zyu43796-byte/Microfluidic-device/hardware/Drop_Board/板2PCB_V1/BD2_yd_V1.0_加工要求.docx

1. 板厚1.6mm，4层板，机械1层做外形和打孔。
2. 绿色，FR-4，过孔塞油。
