zyu43796-byte/Microfluidic-device/hardware/Drop_Board/板4PCB_V1/BD4_yd_V1.0.PcbDoc.htm

Reporting Options

# File in Previous Format

Date | : | 2026-03-22
Time | : | 21:35:51
Filename | : | C:\Users\starry\Desktop\Scientific research horizontal and vertical\玻璃基微型液滴驱动线路板项目\最终版本\液滴电路板WORK\板4PCB_V1\BD4_yd_V1.0.PcbDoc

Version | Warning
Release 12 | CAUTION - Air Gap Width previously controlled by Clearance rule is now controlled by Polygon Connect Style rule's newly introduced Air Gap Width (set to default value). Suggest reviewing each Polygon Connect Style rule's Air Gap Width attribute for correctness.
Release 13 | CAUTION - Silkscreen Over Component Pads Rules are converted to Silk To Solder Mask Clearance Rules. Suggest examining rule scopes for accuracy.

This file was generated by an earlier version of the software
