zyu43796-byte/Microfluidic-device/hardware/Drop_Board/板1PCB_V1/BD1_yd_V1.0_加工要求.docx

1. 板厚2mm，4层板，机械1层做外形和打孔。
2. 绿色，FR-4，过孔塞油。
