zyu43796-byte/Microfluidic-device/hardware/Drop_Board/板4PCB_V1/Project Outputs for Main_board4/Net Status - BD4_dy_V1.html

Altium customize

# Net Status Report

Date | : | 2026/3/2
Time | : | 23:29:19
Elapsed Time | : | 00:00:00
Filename | : | E:\刘博士二版项目\液滴电路板WORK\液滴电路板WORK\板4PCB_V1\BD4_dy_V1.0.PcbDoc
Units | : | mmmils

Nets | Layer | Length
5V | Signal Layers Only | 2730.47mils
DVDD12 | Signal Layers Only | 500.083mils
GND | Signal Layers Only | 7104.11mils
HUB_CC/GPIO1 | Signal Layers Only | 0mils
NetC14_1 | Signal Layers Only | 321.703mils
NetC1_1 | Signal Layers Only | 0mils
NetC1_2 | Signal Layers Only | 124.183mils
NetC22_2 | Signal Layers Only | 623.926mils
NetC40_2 | Signal Layers Only | 398.917mils
NetC41_1 | Signal Layers Only | 304.851mils
NetC42_1 | Signal Layers Only | 283.302mils
NetC44_1 | Signal Layers Only | 332.945mils
NetC46_1 | Signal Layers Only | 3611.28mils
NetC5_2 | Signal Layers Only | 264.728mils
NetC65_1 | Signal Layers Only | 0mils
NetC65_2 | Signal Layers Only | 134.455mils
NetC69_2 | Signal Layers Only | 312.767mils
NetC76_1 | Signal Layers Only | 1425.101mils
NetC85_2 | Signal Layers Only | 126.951mils
NetC94_1 | Signal Layers Only | 280.891mils
NetD10_2 | Signal Layers Only | 0mils
NetD11_2 | Signal Layers Only | 0mils
NetD1_1 | Signal Layers Only | 0mils
NetD8_1 | Signal Layers Only | 3896.258mils
NetH1_1 | Signal Layers Only | 657.583mils
NetH1_2 | Signal Layers Only | 428.135mils
NetH2_2 | Signal Layers Only | 497.015mils
NetH2_3 | Signal Layers Only | 652.686mils
NetH3_3 | Signal Layers Only | 715.537mils
NetK1_8 | Signal Layers Only | 541.645mils
NetLED1_1 | Signal Layers Only | 74.657mils
NetLED2_1 | Signal Layers Only | 71.9mils
NetLED5_1 | Signal Layers Only | 108.025mils
NetP10_1 | Signal Layers Only | 2580.602mils
NetP10_2 | Signal Layers Only | 2557.548mils
NetP10_3 | Signal Layers Only | 794.202mils
NetP10_4 | Signal Layers Only | 2676.501mils
NetP10_5 | Signal Layers Only | 2612.375mils
NetP10_6 | Signal Layers Only | 6292.215mils
NetP10_7 | Signal Layers Only | 2617.896mils
NetP10_8 | Signal Layers Only | 6358.13mils
NetP1_1 | Signal Layers Only | 178mils
NetP3_2 | Signal Layers Only | 0mils
NetQ1_1 | Signal Layers Only | 91.957mils
NetQ2_1 | Signal Layers Only | 0mils
NetQ2_3 | Signal Layers Only | 0mils
NetR16_1 | Signal Layers Only | 444.55mils
NetR17_1 | Signal Layers Only | 427.82mils
NetR2_2 | Signal Layers Only | 261.185mils
NetR43_2 | Signal Layers Only | 310.285mils
NetR45_2 | Signal Layers Only | 987.021mils
NetR48_1 | Signal Layers Only | 110.764mils
NetR6_1 | Signal Layers Only | 82.445mils
NetR8_1 | Signal Layers Only | 77.477mils
OLED_CS | Signal Layers Only | 0mils
OLED_DC | Signal Layers Only | 0mils
OLED_RES | Signal Layers Only | 0mils
OVCUR# | Signal Layers Only | 1632.176mils
P1C_N | Signal Layers Only | 458.976mils
P1C_P | Signal Layers Only | 473.818mils
P1_AS_DX_N | Signal Layers Only | 1367.024mils
P1_AS_DX_P | Signal Layers Only | 1455.835mils
P1_SS_RX_N | Signal Layers Only | 880.331mils
P1_SS_RX_P | Signal Layers Only | 896.364mils
P1_SS_TX_N | Signal Layers Only | 416.21mils
P1_SS_TX_P | Signal Layers Only | 414.817mils
P2C_N | Signal Layers Only | 418.633mils
P2C_P | Signal Layers Only | 413.717mils
P2_AS_DX_N | Signal Layers Only | 2218.174mils
P2_AS_DX_P | Signal Layers Only | 2269.872mils
P2_SS_RX_N | Signal Layers Only | 1425.024mils
P2_SS_RX_P | Signal Layers Only | 1445.144mils
P2_SS_TX_N | Signal Layers Only | 1274.258mils
P2_SS_TX_P | Signal Layers Only | 1293.818mils
P3C_N | Signal Layers Only | 406.763mils
P3C_P | Signal Layers Only | 402.433mils
P3_AS_DX_N | Signal Layers Only | 2649.381mils
P3_AS_DX_P | Signal Layers Only | 2733.871mils
P3_SS_RX_N | Signal Layers Only | 2528.884mils
P3_SS_RX_P | Signal Layers Only | 2473.547mils
P3_SS_TX_N | Signal Layers Only | 2537.716mils
P3_SS_TX_P | Signal Layers Only | 2570.689mils
P4_AS_DX_N | Signal Layers Only | 1068.423mils
P4_AS_DX_P | Signal Layers Only | 1045.576mils
P4_SS_RXA | Signal Layers Only | 0mils
P4_SS_RXB | Signal Layers Only | 0mils
P4_SS_TXA | Signal Layers Only | 0mils
P4_SS_TXB | Signal Layers Only | 0mils
PWREN# | Signal Layers Only | 1681.622mils
PWR_CC/GPIO0/BC_EN# | Signal Layers Only | 590.477mils
RESET# | Signal Layers Only | 211.484mils
SMBCLK/SCL/EXCH# | Signal Layers Only | 886.937mils
SMBDAT/SDA | Signal Layers Only | 927.03mils
SPI_MISO_2 | Signal Layers Only | 0mils
SPI_MOSI_2 | Signal Layers Only | 2162.403mils
SPI_SCK_2 | Signal Layers Only | 0mils
SUSP/PDHUB# | Signal Layers Only | 526.075mils
SWITCH_IN01 | Signal Layers Only | 0mils
SWITCH_IN02 | Signal Layers Only | 0mils
UPC_N | Signal Layers Only | 424.19mils
UPC_P | Signal Layers Only | 419.237mils
UP_AS_DX_N | Signal Layers Only | 1791.996mils
UP_AS_DX_P | Signal Layers Only | 1810.854mils
UP_SS_RX_N | Signal Layers Only | 1753.375mils
UP_SS_RX_P | Signal Layers Only | 1754.34mils
UP_SS_TX_N | Signal Layers Only | 1334.11mils
UP_SS_TX_P | Signal Layers Only | 1354.856mils
USB_5V | Signal Layers Only | 1915.437mils
VBUS_OUT1 | Signal Layers Only | 378.64mils
VBUS_OUT2 | Signal Layers Only | 1978.583mils
VCC_3.3V | Signal Layers Only | 7080.935mils
VCC_5V | Signal Layers Only | 2696.448mils
VDD33 | Signal Layers Only | 7088.882mils
VIN1_12V | Signal Layers Only | 160.886mils
VIN2_12V | Signal Layers Only | 453.186mils
VIN4_12V | Signal Layers Only | 0mils
VIN5_12V | Signal Layers Only | 0mils
VSW | Signal Layers Only | 46.927mils
XI | Signal Layers Only | 376.175mils
XO | Signal Layers Only | 341.821mils

Back to top
