zyu43796-byte/Microfluidic-device/firmware/DRIVE/通信协议.rtf

数字微流控课题组通信协议定义
上位机底板 | 底板加热 | 加热底板 | 底板上位机
| 帧头（2 Byte） | 模块地址（1 Byte） | 命令（1 Byte） | 数据长度（1 Byte） | 数据（x Byte） | 帧尾（2Byte） | 说明 | | | | 说明
底板 | A5A5 | 00 | 01 | 00 | | 5A5A | 芯片压实检测命令 | | | XX | 00压实 01未压实
| A5A5 | 00 | 02 | 00 | | 5A5A | 阵列电压反馈 | | | XX XX | ADC采样 高字节前 低字节后
| A5A5 | 00 | 03 | 00 | | 5A5A | 脉冲电压反馈 | | | XX XX
| A5A5 | 00 | 04 | 02 | Xx xx | 5A5A | 读取EEPROM数据,读取一个;高地址前低地址后 | | | XX
| A5A5 | 00 | 05 | 03 | Xx xx xx | 5A5A | 写入EEPROM数据,写入一个;高地址前低地址后
驱动 | A5A5 | 01 | 05 | 01 | Xx | 5A5A | 设定测试延迟时间1
| A5A5 | 01 | 06 | 01 | Xx | 5A5A | 设定测试延迟时间2
| A5A5 | 01 | 07 | 02 | Xx XX | 5A5A | 设定驱动电压值40-270
| A5A5 | 01 | 08 | 10 | Xx …… xx | 5A5A | 设定控制逻辑
| A5A5 | 01 | 01 | 00 | | 5A5A | 读取电压设定值 | | | XX | 返回已设定值
| A5A5 | 01 | 02 | 00 | | 5A5A | 读取周期设定值 | | | XX
| A5A5 | 01 | 03 | 00 | | 5A5A | 读取控制逻辑 | | | XXXX
| A5A5 | 01 | 04 | 01 | XX | 5A5A | 设定直流交流模式DC:02,AC:03,关闭:01
加热 | A5A5 | 02 | 00 | 00 | | 5A5A | 确认加热模块是否连接正常 | A5 A5 02 00 00 5A5A | A5 A5 02 00 04 XX XX XX XX 5A5A | XX XX XX XX | 返回左右两侧温度
| A5A5 | 02 | 01 | 01 | 01/00 | 5A5A | 左侧启动/左侧停止 | A5 A5 02 01 01 XX 5A 5A | A5 A5 02 01 01 XX 5A 5A | XX | 返回左侧设定状态
| A5A5 | 02 | 02 | 01 | 01/00 | 5A5A | 右侧启动/右侧停止 | A5 A5 02 02 01 XX 5A 5A | A5 A5 02 02 01 XX 5A 5A | XX | 返回右侧设定状态
| A5A5 | 02 | 03 | 02 | Xx xx | 5A5A | 设定左侧目标温度 高字节前低字节后 | A5 A5 02 03 02 XX XX 5A 5A | A5 A5 02 03 02 XX XX 5A 5A | XX XX | 返回左侧设定温度
| A5A5 | 02 | 04 | 02 | Xx xx | 5A5A | 设定右侧目标温度 高字节前低字节后 | A5 A5 02 04 02 XX XX 5A 5A | A5 A5 02 04 02 XX XX 5A 5A | XX XX | 返回右侧设定温度
| A5A5 | 02 | 05 | 06 | Xx xx xx xx xx xx | 5A5A | 设置左侧PID参数 P/I/D高字节前低字节后 | A5 A5 02 05 06 XX XX XX XX XX XX 5A 5A | A5 A5 02 05 06 XX XX XX XX XX XX 5A 5A | XX XX XX XX XX XX | 返回左侧PID参数
| A5A5 | 02 | 06 | 06 | Xx xx xx xx xx xx | 5A5A | 设置右侧PID参数 P/I/D高字节前低字节后 | A5 A5 02 06 06 XX XX XX XX XX XX 5A 5A | A5 A5 02 06 06 XX XX XX XX XX XX 5A 5A | XX XX XX XX XX XX | 返回右侧PID参数
| A5A5 | 02 | 07 | 00 | | 5A5A | 获取当前左侧温度 | A5 A5 02 07 00 5A 5A | A5 A5 02 07 02 XX XX 5A 5A | XX XX | 高字节前低字节后
| A5A5 | 02 | 08 | 00 | | 5A5A | 获取当前右侧温度 | A5 A5 02 08 00 5A 5A | A5 A5 02 08 02 XX XX 5A 5A | XX XX | 高字节前低字节后
| A5A5 | 02 | 09 | 00 | | 5A5A | 获取当前左侧PID参数 | A5 A5 02 09 00 5A 5A | A5 A5 02 09 06 XX XX XX XX XX XX 5A 5A | XX XX XX XX XX XX | P/I/D高字节前低字节后
| A5A5 | 02 | 0a | 00 | | 5A5A | 获取当前右侧PID参数 | A5 A5 02 0A 00 5A5A | A5 A5 02 0A 06 XX XX XX XX XX XX 5A 5A | XX XX XX XX XX XX | P/I/D高字节前低字节后
| A5A5 | 02 | 0b | 00 | | 5A5A | 获取当前左侧加热功率 | A5 A5 02 0b 00 5A 5A | A5 A5 02 0b 02 XX XX 5A 5A | XX XX | 返回左侧加热功率
| A5A5 | 02 | 0c | 00 | | 5A5A | 获取当前右侧加热功率 | A5 A5 02 0c 00 5A 5A | A5 A5 02 0c 02 XX XX 5A 5A | XX XX | 返回右侧加热功率
OLED显示 | A5A5 | 03 | 01 | 00 | | 5A5A | 清屏
| A5A5 | 03 | 02 | 00 | | 5A5A
| A5A5 | 03 | 03 | 00 | | 5A5A | 显示参数
| A5A5 | 03 | 04 | 00 | | 5A5A | 显示状态
磁铁 | A5A5 | | | | | 5A5A
| A5A5 | | | | | 5A5A
荧光 | A5A5 | | | | | 5A5A
| A5A5 | | | | | 5A5A

A5 a5 01 08 10 00 00 00 01 00 00 00 00 00 00 00 00 00 00 00 00 5a 5a
