zyu43796-byte/Microfluidic-device/hardware/Drop_Board/板2PCB_V1/BD2_yd_V1.0_BOM.xlsx

序号 | 名称 | 规格型号 | 标号 | 封装 | 数量 | 立创商城编号 | 厂家型号 | 品牌 |  |  | LibRef
1 | 直插固态电容 | 220UF/50V | C1, C2, C9 | CAP 5.0*10*12.5 | 3 | C19270689 | JBLH2221M050E125RLM 2 | DMBJ(振宝佳) |  | C-CAP
2 | 直插固态电容 | 470uF /16V | C3, C6 | CAP-TH_BD8.0-P3.50-D0.6-FD | 2 | C19270650 | JBLE2471M016D090RLM 4 | DMBJ(振宝佳) |  | JBLE2471M016D090RLM 470UF 16V
3 | 无极性贴片电容 | 100nF | C4, C10, C11, C12, C21, C22, C23, C24, C25, C26, C27, C33, C38, C41, C42, C43, C44, C45, C50, C51, C52, C55, C59, C60, C61, C65, C66, C68 | C0603 | 28 | C14663 | CC0603KRX7R9BB104 | YAGEO(国巨) |  | CGA0603X7R104K500JT
4 | 无极性贴片电容 | 10uF/50V | C5, C37, C56, C62, C67 | C1206 | 5 | C13585 | CL31A106KBHNNNE | SAMSUNG(三星) (https://list.szlcsc.com/brand/254.html) |  | CL31B106KBHNNNE
5 | 直插电解电容 | 220uF/100V | C7 | CAP-TH_BD10.0-P5.00-D0.6-FD-A | 1 | C106683 | ERS1KM221K20OT | AISHI(艾华集团) (https://list.szlcsc.com/brand/1052.html) |  | 2210631013R00
6 | 无极性贴片电容 | 100nF/100V | C8, C40, C47, C63 | C0805 | 4 | C28233 | CL21B104KCFNNNE (https://item.szlcsc.com/28983.html?fromZone=s_s__%220.1uf%20100V%200805%22&c=Z) | SAMSUNG(三星) (https://list.szlcsc.com/brand/254.html?c=Z) |  | CL21B104KCFNNNE
7 | 无极性贴片电容 | 22uF | C13, C53, C54, C58 | C0805 | 4 | C45783 | CL21A226MAQNNNE (https://item.szlcsc.com/46786.html?fromZone=s_s__%2222uF%200805%22&c=Z) | SAMSUNG(三星) (https://list.szlcsc.com/brand/254.html?c=Z) |  | FCC0805X226M250FT
8 | 无极性贴片电容 | 20pF | C19, C20 | C0603 | 2 | C1648 | CL10C200JB8NNNC | SAMSUNG(三星) (https://list.szlcsc.com/brand/254.html?c=Z) |  | CL10C200JB8NNNC
9 | 无极性贴片电容 | 10uF/100V | C39, C46, C64 | C2220 | 3 | C2843466 | FS55X106K101EGG | PSA(信昌电陶) |  | FS55X106K101EGG
10 | 4P连接器 | WAFER-XH254Z-4A | CN2, CN4 | CONN-TH_XH-4A | 2 | C22751788 | WAFER-XH254Z-4AH | HANBO(汉博) (https://list.szlcsc.com/brand/12025.html?c=Z) |  | WAFER-XH254Z-4A
11 | TVS | SMBJ15CA | D2 | SMB_L4.6-W3.6-LS5.4-BI | 1 | C78809 | SMBJ15CA (https://item.szlcsc.com/79946.html?fromZone=s_s__%22SMBJ15CA%22&c=Z) | Littelfuse(美国力特) (https://list.szlcsc.com/brand/110.html?c=Z) |  | SMBJ15CA_C19077570
12 | 肖特基二极管 | SS310 | D3 | SMA_L4.3-W2.6-LS5.0-FD | 1 | C18199183 | SS310B | R+O(宏嘉诚) |  | SS310_C7420364
13 | TVS | SMBJ51CA | D4 | SMB_L4.4-W3.6-LS5.3-BI | 1 | C151265 | SMBJ51CA | Littelfuse(美国力特) |  | SMBJ51CA_C41376101
14 | TVS | SMAJ5.0CA | D5 | SMA_L4.4-W2.6-LS5.0-BI | 1 | C83324 | SMAJ5.0CA | Littelfuse(美国力特) |  | SMAJ5.0CA_C83324
15 | TVS | SMAJ3.3CA | D6 | SMA_L4.4-W2.6-LS5.0-BI | 1 | C2959732 | SMAJ3.3CA | DOWO(东沃) |  | SMAJ3.3CA_C2959732
16 | 肖特基二极管 | MBRS330T3 | D7 | MBRS340 | 1 | C5563747 | MBRS330T3G | FUXINSEMI(富芯森美) |  | DIODE SCHOTTKY
17 | 电感 | 10uH | L1 | IND-SMD_L5.4-W5.2_FXL0530 | 1 | C177248 | FXL0530-100-M | cjiang(长江微电) (https://list.szlcsc.com/brand/11425.html?c=Z) |  | FXL0530-100-M
18 | 电感 | 15uH | L2 | IND-SMD_L7.0-W6.6_FXL0630 | 1 | C177243 | FXL0630-150-M | cjiang(长江微电) |  | FXL0630-150-M
19 | 磁珠 | BLM18PG121SN1D | L3 | L 0603 | 1 | C14709 | BLM18PG121SN1D | muRata(村田) |  | BLM18PG121SN1D
20 | LED灯 | NCD0603G1 | LED1, LED2, LED_h1, LED_h2, LED_h3 | LED0603-RD_1 | 5 | C84267 | NCD0603G1 | 国星光电 |  | NCD0603G1
21 | 2P连接器 | Header 2H | P1 | CONN-TH_2P-P2.54_ZX-XH2.54-2PZZ-Y | 1 | C42441529 | ZX-XH2.54-2PZZ-GW | Megastar(兆星) (https://list.szlcsc.com/brand/15340.html?c=Z) |  | Header 2H
22 | 2*6P排母（底面焊接） | Header 6X2 | P11, P20 | HDR-6X2 | 2 | C2897407 | PM254-2-06-Z-8.5 | HCTL(华灿天禄) (https://list.szlcsc.com/brand/12732.html?c=Z) | 底面焊接！！ | Header 6X2
23 | 2*6P排针25mm | Header 6X2 | P10, P21 | HDR-6X2 | 2 | C49056206 | PZ254V-22-80-A60-2500 | XFCN(兴飞) (https://list.szlcsc.com/brand/12130.html?c=Z) | 手动剪切
24 | 2*10P排针25mm | Header 10X2 | P30 | HDR-10X2 | 1 | C49056206 | PZ254V-22-80-A60-2500 | XFCN(兴飞) (https://list.szlcsc.com/brand/12130.html?c=Z) | 手动剪切 | Header 10X2
25 | N沟道场效应管 | DOZ30N10 | Q2, Q4, Q5 | POWERVDFN-8_L3.2-W3.1-P0.65-LS3.3-BL-1 | 3 | C47018566 | DOZ30N10 | DOINGTER(杜因特) |  | DOZ30N10
26 | 贴片电阻 | 2kΩ | R1, R23, R59, R24 | R0603 | 4 | C22975 | 0603WAF2001T5E | UNI-ROYAL(厚声) |  | 0603WAF2001T5E
27 | 贴片电阻 | 1kΩ | R2 | R0603 | 1 | C25585 | 0603WAJ0102T5E (https://item.szlcsc.com/26328.html?fromZone=s_s__%221k%CE%A9%200603%22&c=Z) | UNI-ROYAL(厚声) |  | 0603WAF1001T5E
28 | 贴片电阻 | 240kΩ | R3 | R0603 | 1 | C4197 | 0603WAF2403T5E | UNI-ROYAL(厚声) (https://list.szlcsc.com/brand/99.html?c=Z) |  | 0603WAF2403T5E
29 | 贴片电阻 | 6.2kΩ | R4 | R0603 | 1 | C4260 | 0603WAF6201T5E | UNI-ROYAL(厚声) |  | 0603WAF6201T5E
30 | 贴片电阻 | 100kΩ | R5, R13, R15, R48 | R0603 | 4 | C2989496 | TC0350B1003T5F (https://item.szlcsc.com/3448919.html?fromZone=s_s__%22C2989496%22) | UNI-ROYAL(厚声) |  | RT0603BRD07100KL
31 | 贴片电阻 | 110kΩ | R6 | R0603 | 1 | C25805 | 0603WAF1103T5E | UNI-ROYAL(厚声) |  | FRC0603F1103TS
32 | 贴片电阻 | 15kΩ | R7 | R0603 | 1 | C22809 | 0603WAF1502T5E | UNI-ROYAL(厚声) |  | FRC0603F1502TS
33 | 贴片电阻 | 10kΩ | R8, R21, R22, R27, R44, R50, R61, R69, R70, R71, R72, R73, R74 | R0603 | 13 | C2989264 | TC0350B1002T5F (https://item.szlcsc.com/3448687.html?fromZone=s_s__%22C2989264%22) | UNI-ROYAL(厚声) |  | 0603WAF1002T5E
34 | 贴片电阻 | 510Ω | R9, R10 | R0603 | 2 | C23193 | 0603WAF5100T5E | UNI-ROYAL(厚声) |  | 0603WAF5100T5E
35 | 贴片电阻 | 1MΩ | R11 | R0603 | 1 | C22935 | 0603WAF1004T5E | UNI-ROYAL(厚声) |  | 0603WAF1004T5E
36 | 贴片电阻 | 47Ω | R12, R17, R18, R25, R36, R37, R38, R39, R56, R57, R60, R26 | R0603 | 12 | C1211 | 0603WAJ0470T5E | UNI-ROYAL(厚声) |  | 0603WAF470JT5E
37 | 贴片电阻 | 10Ω | R14, R16, R30, R31, R32, R33, R51, R52, R42, R43 | R0603 | 10 | C25202 | 0603WAJ0100T5E | UNI-ROYAL(厚声) |  | 0603WAF6201T5E, 0603WAF6201T5E, 0603WAF100JT5E, 0603WAF100JT5E, 0603WAF6201T5E, 0603WAF6201T5E, 0603WAF100JT5E, 0603WAF100JT5E
38 | 贴片电阻 | 330Ω | R19, R20, R62 | R0603 | 3 | C23138 | 0603WAF3300T5E | UNI-ROYAL(厚声) |  | FRC0603J331 TS
40 | 贴片电阻 | 820mΩ | R29 | RES-SMD_L6.4-W3.2-1 | 1 | C2960726 | FRL2512FR820TS | FOJAN(富捷) |  | RLP25FEER400
41 | 贴片电阻 | 4.7kΩ | R34, R35 | R0603 | 2 | C23162 | 0603WAF4701T5E | UNI-ROYAL(厚声) |  | 0603WAF4701T5E
42 | 贴片电阻 | 130mΩ | R46 | RES-SMD_L6.4-W3.2-R2512 | 1 | C2934370 | FRL2512JR130TS | FOJAN(富捷) |  | FRM252WFR100TN
43 | 贴片电阻 | 330mΩ | R53 | RES-SMD_L6.4-W3.2-R2512 | 1 | C2960712 | FRL2512FR330TS | FOJAN(富捷) |  | FRM252WFR100TN
44 | 按键 | SKRPACE010 | SW1 | KEY-SMD_4P-L4.2-W3.2-P2.20-LS4.6 | 1 | C139797 | SKRPACE010 | ALPSALPINE(阿尔卑斯阿尔派) |  | SKRPACE010
45 | 自恢复保险丝 | 1812L300/24GR | U1 | F1812 | 1 | C20627123 | 1812L300/24GR | LUTE(陆特) |  | 1812L300/24GR
46 | 芯片 | LGS6302EP | U2 | ESOP-8_L4.9-W3.9-P1.27-LS6.0-BL-EP-4 | 1 | C5280693 | LGS6302EP | Legend-Si(棱晶半导体) |  | LGS6302EP
47 | 芯片 | MT2492 | U3 | SOT-23-6_L2.9-W1.6-P0.95-LS2.8-BL_3 | 1 | C89358 | MT2492 | 西安航天民芯 |  | MT2492
48 | 芯片 | STM32F103C8T6 | U6 | LQFP-48_L7.0-W7.0-P0.50-LS9.0-BL | 1 | C8734 | STM32F103C8T6 (https://item.szlcsc.com/9243.html?fromZone=s_s__%22STM32F103C8T6%22&c=Z) | ST(意法半导体) |  | STM32F103C8T6
49 | 芯片 | ADS1220IPWR | U8 | TSSOP-16_L5.0-W4.4-P0.65-LS6.4-BL | 1 | C48263 | ADS1220IPWR | TI(德州仪器) |  | ADS1220IPWR
50 | 芯片 | INA226AIDGSR | U10, U11, U16 | MSOP-10_L3.0-W3.0-P0.50-LS5.0-BL | 3 | C49851 | INA226AIDGSR | TI(德州仪器) |  | INA226AIDGSR
51 | 芯片 | CJ6109B33M | U12 | SOT-23-5_L2.9-W1.6-P0.95-LS2.8-BR | 1 | C17703066 | CJ6109B33M | CJ(江苏长电/长晶) |  | CJ6109B33M
52 | 芯片 | UCC27517DBVR | U13, U14, U15 | SOT-23-5_L3.0-W1.7-P0.95-LS2.8-BR | 3 | C20623191 | UCC27517DBVR(UMW) | UMW(友台半导体) |  | UCC27517DBVR
53 | 晶振 | 8MHz | X1 | CRYSTAL-SMD_4P-L3.2-W2.5-BL | 1 | C2682774 | X32258MSB4SI (https://item.szlcsc.com/2777871.html?fromZone=s_s__%228MHz%203225%2020p%22) | YXC(扬兴晶振) |  | X32258MSB4SI
