zyu43796-byte/Microfluidic-device/hardware/Drop_Board/板3PCB_V1/BD3_yd_V1.0_BOM.xlsx

序号 | 名称 | 规格型号 | 标号 | 封装 | 数量 | 立创商城编号 | 厂家型号 | 品牌 |  | LibRef
1 | 无极性贴片电容 | 0.1uF | C1, C2, C4, C5, C9, C10, C11, C12, C13, C14, C15, C16, C17, C18, C19, C61, C64, C91, C92, C96 | C 0603 | 20 | C14663 | CC0603KRX7R9BB104 | YAGEO(国巨)
2 | 无极性贴片电容 | 1uF | C3, C8, C62, C63, C90 | C 0603 | 5 | C15849 | CL10A105KB8NNNC (https://item.szlcsc.com/16531.html?fromZone=s_s__%221uF%200603%22) | SAMSUNG(三星) (https://list.szlcsc.com/brand/254.html)
3 | 无极性贴片电容 | 20pF | C6, C7 | C 0603 | 2 | C1648 | CL10C200JB8NNNC | SAMSUNG(三星) (https://list.szlcsc.com/brand/254.html)
4 | 无极性贴片电容 | 0.1uF/50V | C20 | C 1206 | 1 | C24497 | CL31B104KBCNNNC | SAMSUNG(三星) (https://list.szlcsc.com/brand/254.html)
5 | 无极性贴片电容 | 10uF/50V | C21 | C 1206 | 1 | C13585 | CL31A106KBHNNNE | SAMSUNG(三星) (https://list.szlcsc.com/brand/254.html)
6 | 直插电解电容 | 220UF/50V | C22 | CAP 5.0*10*12.5 | 1 | C19270689 | JBLH2221M050E125RLM 2 | DMBJ(振宝佳)
7 | 肖特基二极管 | MBRS330T3 | D7 | MBRS340 | 1 | C5563747 | MBRS330T3G | FUXINSEMI(富芯森美) |  |  | DIODE SCHOTTKY
8 | 4P连接器 | 4P 2.54 | H6 | CONN-TH_4P-P2.50_ZX-XH2.54-4PZZ-Y | 1 | C22388510 | BX-XH2.54-4PZZ-Y | Bossie(博锡) |  |  | HB-PH3-25414PB2GOP
9 | 120欧姆磁珠 | 120欧姆磁珠 | L1, L8, L9 | L 0603 | 3 | C14709 | BLM18PG121SN1D | muRata(村田) |  |  | FERRITBEAD
10 | 红色LED | 红色 | LED1 | LED 0603R | 1 | C84263 | NCD0603R1 | 国星光电 |  |  | LED-SMD
11 | 绿色LED | 绿色 | LED4 | LED 0603G | 1 | C84267 | NCD0603G1 | 国星光电 |  |  | LED-SMD
12 | 线板连接器 | BX-XH2.54-5PZZ-Y | P1 | CONN-TH_BX-XH2.54-5PZZ-Y | 1 | C22388511 | BX-XH2.54-5PZZ-Y | Bossie(博锡) |  |  | BX-XH2.54-5PZZ-Y
13 | 2*10PP排母（底面焊接） | Header 10X2 | P10 | HDR-10X2 | 1 | C2897411 | PM254-2-10-Z-8.5 | HCTL(华灿天禄) (https://list.szlcsc.com/brand/12732.html?c=Z) | 底面焊接！！ |  | Header 10X2
14 | 2*6P排针25mm | Header 6X2 | P11, P20 | HDR-6X2 | 2 | C49056206 | PZ254V-22-80-A60-2500 | XFCN(兴飞) (https://list.szlcsc.com/brand/12130.html?c=Z) | 手动剪切 |  | Header 6X2
15 | 2*6P排母（底面焊接） | Header 6X2 | P30 | HDR-6X2 | 1 | C2897407 | PM254-2-06-Z-8.5 | HCTL(华灿天禄) (https://list.szlcsc.com/brand/12732.html?c=Z) | 底面焊接！！ |  | Header 6X2
16 | 贴片电阻 | 4.7K | R1, R2 | R 0603 | 2 | C23162 | 0603WAF4701T5E | UNI-ROYAL(厚声)
17 | 贴片电阻 | 100K | R3, R4 | R 0603 | 2 | C25803 | 0603WAF1003T5E | UNI-ROYAL(厚声)
18 | 贴片电阻 | 1M | R5 | R 0603 | 1 | C17514 | 0805W8F1004T5E | UNI-ROYAL(厚声)
19 | 贴片电阻 | 1K | R6, R9 | R 0603 | 2 | C21190 | 0603WAF1001T5E | UNI-ROYAL(厚声)
20 | 贴片电阻 | 10K | R10, R40, R49, R50 | R 0603 | 4 | C25804 | 0603WAF1002T5E | UNI-ROYAL(厚声)
21 | 贴片电阻 | 10R | R11, R12 | R 0603 | 2 | C25202 | 0603WAJ0100T5E | UNI-ROYAL(厚声)
22 | 贴片电阻 | 0R | R41 | R 0603 | 1 | C21189 | 0603WAF0000T5E | UNI-ROYAL(厚声)
23 | 2路编码开关 | CSW-2P | SW1 | CSW1.27 SMD-2P | 1 | C3294661 | SOP02 | BIWIN(百莹)
24 | 3x6轻触开关 | 3x6x5 | SW2 | TSW SMD-3*6*2.5 | 1 | C5117870 | GT-TC060A-H025-L1 | G-Switch(品赞)
25 | 芯片 | STM32F407VET6 | U4 | LQFP100 14x14_N | 1 | C28729 | STM32F407VET6 | ST(意法半导体) |  |  | STM32F407VET6
26 | 芯片 | 24C64 | U5 | SOP8_N | 1 | C6487 | AT24C64D-SSHM-T | MICROCHIP(美国微芯) |  |  | 24LC02
27 | 芯片 | ADUM1201BRZ | U15 | SOIC-8_L4.9-W3.9-P1.27-LS6.0-BL | 1 | C87626 | ADUM1201BRZ-RL7 | ADI(亚德诺) |  |  | ADUM1201BRZ
28 | 高速开关二极管 | 1N4148 | VD7, VD8 | SOD-323 | 2 | C7420319 | 1N4148WS | 宏嘉诚
29 | 4脚晶振 | 8M | X1 | XTAL-3225 | 1 | C2682774 | X32258MSB4SI | YXC(扬兴晶振)
