zyu43796-byte/Microfluidic-device/hardware/Drop_Board/板4PCB_V1/BD4_dy_V1.0_BOM.xlsx

序号 | 名称 | 规格型号 | 标号 | 封装 | 数量 | 立创商城编号 | 厂家型号 | 品牌 |  |  | LibRef
1 | 无极性贴片电容 | 0.01uF | C1, C65 | C 1206 | 2 | C107192 | CC1206KKX7RCBB103 | YAGEO(国巨) |  |  |  | C
2 | 直插固态电容 | 470uF /16V | C2, C46, C51, C67, C79, C89 | CAP-TH_BD8.0-P3.50-D0.6-FD | 6 | C19270650 | JBLE2471M016D090RLM 4 | DMBJ(振宝佳) |  |  |  | JBLE2471M016D090RLM 470UF 16V
3 | 无极性贴片电容 | 10uF | C3, C16, C22, C68, C80, C82 | C 0805 | 6 | C15850 | CL21A106KAYNNNE | SAMSUNG(三星) (https://list.szlcsc.com/brand/254.html) |  |  |  | C, C-CC, C, C, C, C-CC
4 | 无极性贴片电容 | 0.1uF | C4, C20, C39, C40, C43, C44, C66, C81, C83, C95 | C 0603 | 10 | C14663 | CC0603KRX7R9BB104 | YAGEO(国巨) |  |  |  | C, C-CC, C, C, C-CC, C-CC, C, C-CC, C-CC, C-CC
5 | 无极性贴片电容 | 0.1uF/50V | C5, C6, C69, C70, C75, C84, C85 | C 1206 | 7 | C24497 | CL31B104KBCNNNC | SAMSUNG(三星) (https://list.szlcsc.com/brand/254.html) |  |  |  | C
6 | 无极性贴片电容 | 10uF/50V | C7, C71, C74 | C 1206 | 3 | C13585 | CL31A106KBHNNNE | SAMSUNG(三星) (https://list.szlcsc.com/brand/254.html) |  |  |  | C
7 | 直插电解电容 | 220UF/50V | C8, C72, C73, C78 | CAP 5.0*10*12.5 | 4 | C19270689 | JBLH2221M050E125RLM 2 | DMBJ(振宝佳) |  |  |  | C-CAP
8 | Capacitor | 10uF | C9, C18, C30 | 0603_C | 3 | C96446 | CL10A106KP8NNNC (https://item.szlcsc.com/20411.html?fromZone=s_s__%2210uF%200603%22&c=Z) | SAMSUNG(三星) |  |  |  | Cap
9 | Capacitor | 0.1uF | C10, C12, C13, C19, C21, C23, C24, C25, C26, C27, C28, C35, C36, C37, C38, C47, C48, C49, C50, C11 | 0402_C | 20 | C1525 | CL05B104KO5NNNC | SAMSUNG(三星) |  |  |  | CAP
10 | 无极性贴片电容 | 1uF | C14, C45, C94 | C 0603 | 3 | C15849 | CL10A105KB8NNNC (https://item.szlcsc.com/16531.html?fromZone=s_s__%221uF%200603%22) | SAMSUNG(三星) (https://list.szlcsc.com/brand/254.html) |  |  |  | C-CC
11 | 直插电解电容 | 100uF | C17, C31, C32 | CD0.1 | 3 | C51904467 | ERG35V100M6X11 | JIERR(捷而瑞) |  |  |  | CAP
12 | 无极性贴片电容 | 1uF | C29 | 0402_C | 1 | C52923 | CL05A105KA5NQNC | SAMSUNG(三星) |  |  |  | Cap
13 | 无极性贴片电容 | 20pF | C33, C34 | 0402_C | 2 | C327010 | CC0402FRNPO9BN200 | YAGEO(国巨) |  |  |  | CAP
14 | 无极性贴片电容 | 20PF | C41, C42 | C 0603 | 2 | C1648 | CL10C200JB8NNNC | SAMSUNG(三星) (https://list.szlcsc.com/brand/254.html) |  |  |  | C
15 | 直插铝电解电容 | 4.7uF/400V | C76, C88 | CAP-TH_BD8.0-P3.50-D0.6-FD | 2 | C721086 | EGW2WM4R7F12C35T | AISHI(艾华集团) |  |  |  | ERK2GM4R7F09OT
16 | 无极性贴片电容 | 0.1uF/450V | C77 | C 1206 | 1 | C342732 | C3216X7T2W104KT000N | TDK |  |  |  | C
17 | 肖特基二极管 | MBRS330T3 | D1, D3, D8, D9, D19 | MBRS340 | 5 | C5563747 | MBRS330T3G | FUXINSEMI(富芯森美) |  |  |  | DIODE SCHOTTKY
18 | TVS | SMAJ5.0CA | D2, D12, D18, D20, D21, D22 | SMA_L4.4-W2.6-LS5.0-BI | 6 | C83324 | SMAJ5.0CA | Littelfuse(美国力特) |  |  |  | SMAJ5.0CA_C83324
19 | TVS/ESD | CH412K | D4, D6, D14, D16 | SOT-363_L2.0-W1.3-P0.65-LS2.1-BR | 4 | C89184 | CH412K (https://item.szlcsc.com/90364.html?fromZone=s_s__%22CH412K%22&c=Z) | WCH(南京沁恒) |  |  |  | CH412K
20 | TVS/ESD | TPD4E02B04QDQARQ1 | D5, D7, D15, D17 | USON-10_L2.5-W1.0-P0.50-BL | 4 | C20416617 | BNTPD4E02B04DQAR (https://item.szlcsc.com/21749718.html?fromZone=s_s__%22TPD4E02B04%22&c=Z) | BORN(伯恩半导体) |  |  |  | TPD4E02B04QDQARQ1
21 | TVS | SMBJ18CA | D10 | SMB | 1 | C83327 | SMBJ18CA | Littelfuse(美国力特) |  |  |  | 1.04.03.0004
22 | 快恢复/高效率二极管 | ES2J | D11 | SMB_L4.4-W3.6-LS5.4-RD | 1 | C330479 | ES2J | LGE(鲁光) |  |  |  | ES2J_C19078414
23 | TVS | SMAJ3.3CA | D13 | SMA_L4.4-W2.6-LS5.0-BI | 1 | C2959732 | SMAJ3.3CA | DOWO(东沃) |  |  |  | SMAJ3.3CA_C2959732
24 | 肖特基二极管 | B540C | DV1, DV2 | SMC_L7.1-W6.2-LS8.1-RD | 2 | C72264 | B540C-13-F | DIODES(美台) |  |  |  | B540C-13-F
25 | 贴片保险丝 | MSMD200-25V 4A | F1, F2 | FU 1812 | 2 | C143954 | MSMD200-24V | 台湾陆海 |  |  |  | FU
26 | 2P连接器 | Header 2H | H1 | CONN-TH_2P-P2.54_ZX-XH2.54-2PZZ-Y | 1 | C42441529 | ZX-XH2.54-2PZZ-GW | Megastar(兆星) (https://list.szlcsc.com/brand/15340.html?c=Z) |  |  |  | Header 2H
27 | 4P连接器 | Header 4H | H2, H3 | CONN-TH_4P-P2.50_ZX-XH2.54-4PZZ-Y | 2 | C22388510 | BX-XH2.54-4PZZ-Y | Bossie(博锡) |  |  |  | HB-PH3-25414PB2GOP
28 | 继电器 | G6K-2F-Y-DC5 | K1 | RELAY-SMD_G6K-2F-Y | 1 | C326376 | G6K-2F-Y-DC5 | OMRON(欧姆龙) |  |  |  | G6K-2F-Y-DC12
29 | 电感 | 15uH /5A | L1, L10 | IND-SMD_L8.5-W8.0_PCC-M0854M | 2 | C2962886 | PSPMAA0805-150M-ANP | PROD(谱罗德) |  |  |  | PSPMAA0805-150M-ANP
30 | 电感 | 2.2uH | L2 | CD32 | 1 | C135262 | SMNR4020-2.2UH | SXN(顺翔诺) |  |  |  | Inductor
31 | 120欧姆磁珠 | 120欧姆磁珠 | L3, L4, L5, L12 | L 0603 | 4 | C14709 | BLM18PG121SN1D | muRata(村田) |  |  |  | FERRITBEAD
32 | 电感 | 100uH | L11 | IND-SMD_L18.3-W17.0 | 1 | C2931812 | YSPIA1770-101M | YJYCOIN(益嘉源) |  |  |  | YSPIA1770-101M
33 | 绿色LED | 绿色 | LED1,LED2,LED5 | 0603+ | 3 | C84267 | NCD0603G1 | 国星光电 |  |  |  | LED
34 | —— | Port Swap | P1 | SIP2-2.54mm | 1 | —— | —— | —— |  |  |  | HEADER 2
35 | USB 3.0 TYPEA | PC | P2,P4,P6,P7 | USB3.0-A-Receptacle | 4 | C7501850 | HC-USB3.0-L168-WP | HC(虹成电子) |  |  |  | USB-AF3.0-90卷
36 | —— | Header 2 | P3 | SIP2-3.5mm | 1 | —— | —— | —— |  | 淘宝链接： |  | Header 2
37 | 电源接口 | DC-007B 5.5*2.1mm 10A | P5 | POWERPLUG_slc | 1 |  |  |  | 淘宝买5.5*2.1mm的 | 10A大电流全铜镀金DC007B电源插座 、内针5.5*2.1/2.5 带铜壳插座-淘宝网 (https://item.taobao.com/item.htm?id=564481068577) |  | DC_plug
38 | —— |  | P8 | SIP5-2.54mm | 1 | —— | —— | —— |  |  |  | HEADER 5
39 | 3P连接器 | HX-XH2.54-3PZZ-R | P9 | CONN-TH_3P-P2.50_HX-XH2.54-3PZZ-B | 1 | C49010011 | HX-XH2.54-3PZZ-R (https://item.szlcsc.com/51365932.html?fromZone=s_s__%22HX-XH2.54-3PZZ-R%22&c=Z) | hanxia(韩下) (https://list.szlcsc.com/brand/14053.html?c=Z) |  |  |  | HX-XH2.54-3PZZ-R
40 | 2*6P排针25mm | 2*6P排针25mm | P10 | HDR-10X2 | 1 | C49056206 | PZ254V-22-80-A60-2500 | XFCN(兴飞) (https://list.szlcsc.com/brand/12130.html?c=Z) | 手动剪切 |  |  | Header 10X2
41 | 2*10P排针25mm | 2*6P排针25mm | P30 | HDR-6X2 | 1 | C49056206 | PZ254V-22-80-A60-2500 | XFCN(兴飞) (https://list.szlcsc.com/brand/12130.html?c=Z) | 手动剪切 |  |  | Header 6X2
42 | NPN三极管 | 9013 | Q1 | SOT23 | 1 | C20069127 | S9013 | 宏嘉诚 |  |  |  | 2N2222
43 | 场效应管 | MOT65R600D | Q2 | TO-252-3_L6.6-W6.1-P4.58-LS10.1-BR-1 | 1 | C5143201 | MOT65R600D | MOT(仁懋) |  |  |  | MOT65R600D
44 | 贴片电阻 | 100K | R1, R42 | R 0603 | 2 | C25803 | 0603WAF1003T5E | UNI-ROYAL(厚声) |  |  |  | R
45 | 贴片电阻 | 10K | R2, R14, R43 | R 0603 | 3 | C25804 | 0603WAF1002T5E | UNI-ROYAL(厚声) |  |  |  | R, Res2, R
46 | 贴片电阻 | 3.16K | R3, R44 | R 0603 | 2 | C52603 | 0805W8F3161T5E | UNI-ROYAL(厚声) |  |  |  | R
47 | 贴片电阻 | 10K | R4,R5 | 0402 | 2 | C407753 | 0402WGD1002TCE | UNI-ROYAL(厚声) |  |  |  | RES
48 | 贴片电阻 | 24K | R6, R8 | 0402 | 2 | C25769 | 0402WGF2402TCE | UNI-ROYAL(厚声) |  |  |  | RES
49 | 贴片电阻 | NC(51K) | R7, R9 | 0402 | 2 | C25794 | 0402WGF5102TCE | UNI-ROYAL(厚声) |  |  |  | RES
50 | 贴片电阻 | NC(10K) | R10 | 0402 | 1 | —— | —— | —— |  |  |  | RES
51 | 贴片电阻 | 2K | R11 | 0402 | 1 | C2909344 | FRC0402F2001TS | FOJAN(富捷) |  |  |  | RES
52 | 贴片电阻 | 1K | R12 | 0402 | 1 | C2906864 | FRC0402F1001TS | FOJAN(富捷) |  |  |  | RES
53 | 贴片电阻 | 1K | R13, R46 | R 0603 | 2 | C21190 | 0603WAF1001T5E | UNI-ROYAL(厚声) |  |  |  | Res2, R
54 | 贴片电阻 | 0R | R15 | R 0603 | 1 | C21189 | 0603WAF0000T5E | UNI-ROYAL(厚声) |  |  |  | R
55 | 贴片电阻 | 22R | R16, R17, R18, R19 | R 0603 | 4 | C23345 | 0603WAF220JT5E | UNI-ROYAL(厚声) |  |  |  | R
56 | 贴片电阻 | 1.5M | R45 | RES-TH_BD2.4-L6.3-P10.30-D0.6 | 1 | C2903255 | MF1/4W-1M5±1%-ST26 | VO(翔胜) |  |  |  | R
57 | 贴片电阻 | 0.1R | R47 | R 1812 | 1 | C473601 | 181207F100LT4E | UNI-ROYAL(厚声) |  |  |  | R
58 | 贴片电阻 | 6.8K | R48 | R 0603 | 1 | C23212 | 0603WAF6801T5E | UNI-ROYAL(厚声) |  |  |  | R
59 | 芯片 | TPS5450DDAR | U1, U16 | SOP-8_L4.9-W3.9-P1.27-LS6.0-BL-EP | 2 | C114425 | TPS5450DDAR | TI(德州仪器) |  |  |  | TPS5450DDAR
60 | 芯片 | CH634M | U2 | QFN48_5X5 | 1 | C49118549 | CH634M | WCH(南京沁恒) |  |  |  | CH634M
61 | 芯片 | CH217K | U3, U5 | SOT-23-6 | 2 | C7462749 | CH217K (https://item.szlcsc.com/8495424.html?fromZone=s_s__%22CH217K%22&c=Z) | WCH(南京沁恒) (https://list.szlcsc.com/brand/271.html?c=Z) |  |  |  | CH217K
62 | 芯片 | ADUM1200BRZ-RL7 | U4 | SOIC-8_L4.9-W3.9-P1.27-LS6.0-BL | 1 | C30230 | ADUM1200BRZ-RL7 | ADI(亚德诺) |  |  |  | ADUM1200BRZ-RL7
63 | 芯片 | CH213K | U6 | SOT-23-3 | 1 | C5456874 | CH213K | WCH(南京沁恒) (https://list.szlcsc.com/brand/271.html?c=Z) |  |  |  | CH213K
64 | 芯片 | CH341T | U7 | SSOP-20 | 1 | C23971 | CH341T | WCH(南京沁恒) |  |  |  | CH341T
65 | 芯片 | MAX1771ESA | U17 | SOP8_N | 1 | C407903 | MAX1771ESA+T | MAXIM(美信) |  |  |  | MAX1771ESA
66 | 芯片 | MCP41050-I/SN | U18 | SOIC-8_L4.9-W3.9-P1.27-LS6.0-BL | 1 | C124138 | MCP41050-I/SN | MICROCHIP(美国微芯) |  |  |  | MCP41050-I/SN
67 | 三端稳压芯片 | AMS1117-3V3 | V1 | SOT223_M | 1 | C5120765 | AMS1117-3.3V | MSKSEMI(美森科) |  |  |  | AMS1117
68 | 瞬态电压抑制二极管 | SMF15CA | VD1, VD2 | SOD-123F | 2 | C19077510 | SMF15CA | 宏嘉诚 |  |  |  | DR
69 | 4脚晶振 | 24MHz | X1 | XT3225 | 1 | C15643 | X322524MSB4SI (https://item.szlcsc.com/16324.html?fromZone=s_s__%2224MHz%203225%22) | YXC(扬兴晶振) (https://list.szlcsc.com/brand/287.html) |  |  |  | 晶体
70 | 4脚晶振 | 12M | X2 | XTAL-3225 | 1 | C133334 | TAXM12M4RLBDDT2T | YJX(雅晶鑫) |  |  |  | XTAL-4
