zyu43796-byte/Microfluidic-device/hardware/Drop_Board/功能信号表_260111.xlsx

Sheet: 信号表
 | 功能模块 | 输入 | 输出 | 转接
板1 | 高压脉冲电源转换 | VCC_5V
 |  | GND
 |  | V_HV1
 |  |  | ~~V_HV_C1~~
 |  |  | ~~VDD_C1~~
 |  |  | ~~GND_C1~~ |  |  | 反相器SN74AC14D
 |  | AC
 | 阵列板1和2的PCIE接口 | VCC_3.3V
 |  | GND
 |  | ZL1_ZL2_B\L\ | FOR_507B\L\
 |  | ZL1_ZL2_POL | FOR_507P\O\L\
 |  | ZL1_ZL2_CLK | FOR_507CLK |  | CLK和DIO使用一个SPI接口进行数据发送，和原版一样
 |  | ZL1_ZL2_LE | FOR_507L\E\
 |  | ZL1_ZL2_DIOA | FOR_507DIO
 |  | H1_48V（heater1+ H2_Left）
 |  | H1_D1（heater1- H1_Left） |  |  | 该部分更改为三个加热电极，三个电极共源不共地，一个电极用于外接电源，其余电极外接加加热控制模块
 |  | H2_48V（heater2+ H3_right）
 |  | H2_D2（heater2- H4_right） |  |  | 加热管脚连线直接连接弹簧针，不通过PCIE接口
 |  | H3_48V
 |  | H3_D3
 |  | NTC1- |  |  | 对应加热需要三对连接管教，也是不通过PCIE连接口
 |  | NTC1+
 |  | NTC2+
 |  | NTC2-
 |  | NTC3-
 |  | NTC3+
 |  | ~~V_GND~~ |  |  | V_GND该地直接通过弹簧针连接芯片，不通过PCIE接口
 |  |  | bioarray_check
 | 反馈及波形峰值采集 | ADC0
 |  | ADC2
 | 功能模块 | 输入 | 输出 | 转接 | 需要不断进行参数更新，单独用一个C8T6芯片控制加热部分
板2 | 加热板 | VIN3_12V |  | VCC_5V
 |  | GND |  | VCC_3.3V
 |  | TXD3_RS232 |  | GND | 用于加热模块通信，不使用232通信，标准串口TTL电平即可
 |  | RXD3_RS232 |  | FOR_507B\L\
 |  | H1_48V（heater1+ H2_Left） |  | FOR_507P\O\L\
 |  | H1_D1（heater1- H1_Left） |  | FOR_507CLK
 |  | H2_48V（heater2+ H3_right） |  | FOR_507L\E\ | 改成三对
 |  | H2_D2（heater2- H4_right） |  | FOR_507DIO
 |  | H3_48V |  | ADC0
 |  | H3_D3 |  | ADC2
 |  | NTC1+ |  | AC
 |  | NTC1- |  | bioarray_check
 |  | NTC2+
 |  | NTC2-
 |  | NTC3-
 |  | NTC3+
 |  |  | posSW1 |  |  | 微动开关
 |  |  | GND
 | 功能模块 | 输入 | 输出 | 转接
板3 | 主控CPU模块 | VCC_3.3V |  | VCC_5V | 供电
 |  | GND |  | VCC_3.3V
 |  |  |  | GND
 |  | Biochip_check |  | VIN3_12V | 检测芯片压实
 |  |  | TXD1_PC | GND | 连接到板4用于上位机通信
 |  |  | RXD1_PC
 |  |  | AC |  | 定时器用于产生脉冲高压
 |  | ADC0 |  |  | 位置检测采样与脉冲高压检测采样
 |  | ADC2
 |  |  | FOR_507CLK |  | CLK与DIOA使用一个SPI接口数据脚与时钟脚，和原版一样
 |  |  | FOR_507P\O\L\
 |  |  | FOR_507B\L\
 |  |  | FOR_507L\E\
 |  |  | FOR_507DIOA
 |  |  | SPI_SCK_3 |  | 用于控制高压数值大小
 |  |  | SPI_MOSI_3
 |  |  | POT1_CS |  | 数字电位器片选
 |  |  | TXD3_RS232 |  | 不转232，使用TTL电平
 |  |  | RXD3_RS232
 |  | posSW1 |  |  |  | 微动开关
 |  | GND
 |  | Magnet_CTL
 | 功能模块 | 输入 | 输出 | 转接
板4 | 电源模块： VIN1_12V 12V转5V给主板， VIN2_12V 12V给高压， VIN3_12V 给加热， VIN4_12V 一个USBhub， VIN5_12V 给荧光。 USB hub功能：一转四。 电机控制。 串口转USB。 | 输入12V10A
 |  | GND
 |  | POT1_CS |  |  | 用于数字电位器控制高压数值
 |  | SPI_SCK_3
 |  | SPI_MOSI_3
 |  |  | V_HV1 |  | 高压
 |  |  | GND
 |  |  | VCC_3.3V |  | CPU
 |  |  | VCC_5V |  | 模拟
 |  |  | VIN3_12V |  | 给加热
 |  | Magnet_CTL |  |  | 电机控制 | 是否可用PWM控制模式？
 |  | TXD1_PC |  |  | 主控串口
 |  | RXD1_PC
 |  | TXD4_HV |  |  | 荧光串口
 |  | RXD4_HV
 | ~~指示灯~~
 | 灯带
 | 微动开关接口
 | 显示屏
 | 开关板固定
 | 电路板开槽走线

Sheet: 外购件链接
序号 | 标号 | 项目名称 | 规格型号 | 数量 | 价格 | 链接
1 |  | 电源接头 | 10A电源插座DC007B，内针5.5*2.1mm | 1 |  | https://item.taobao.com/item.htm?id=564481068577&spm=a21m98.27004841
2 |  | USB TYPE-C | USB3.1 TYPE-C 16Pin卧贴 | 1 |  | GT-USB-7001A中文资料_最新报价_数据手册下载_G-Switch(品赞)-USB连接器-立创商城 (https://item.szlcsc.com/2892009.html?fromZone=s_s__%22type-C%203.0%2024pin%22)
3 |  | USB TYPE-A | USB3.1 TYPE-C 16Pin卧贴 | 3 |  | GSB4111312HR_Amphenol-实物图-PCB引脚图-焊盘图-立创商城一站式电子元器件采购自营商城_嘉立创电子商城 (https://item.szlcsc.com/product/jpg_6305170.html)
4 |  | 双排插针 | 2.54mm间距 2*5 | 10 |  | PZ254V-22-10-A60-2500中文资料_最新报价_数据手册下载_XFCN(兴飞)-排针-立创商城 (https://item.szlcsc.com/51423243.html)
5 |  | 双排母 | 2.54mm间距 2*5 | 10 |  | PM254-2-05-Z-8.5中文资料_最新报价_数据手册下载_HCTL(华灿天禄)-排母-立创商城 (https://item.szlcsc.com/3142411.html?fromZone=s_s__%22PM254-2-05-Z-8.5%22)
6 |  | PCIE3.0 DIP连接器 | PCIe 98P立插 | 2 |  | 3183-10112P1T中文资料_最新报价_数据手册下载_UMaxconn(友贸)-PCI/PCIe连接器-立创商城 (https://item.szlcsc.com/391113.html?fromZone=s_s__%22C404111%22)
7
8
9
10
