zyu43796-byte/Microfluidic-device/host/chip/chip_shape.dxf

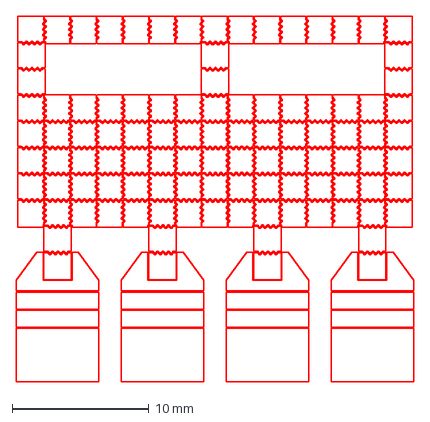
[picture p4: CAD file, 2026-10-15]
host/chip/chip_shape.dxf
29.0 x 26.7 mm
