zyu43796-byte/Microfluidic-device/docs/upload-verification.md

# 上传快照核对

- 固件来自当前设备工程，Src/Inc与原文件逐一SHA256比对一致；Keil项目引用的源文件全部存在。
- 上位机来自当前已打包使用版本；启动资源与控制模块校验一致。
- 当前源码含73项离线测试，之前版本验证记录为全部通过。本次在复制后的仓库运行完整测试时，多数测试通过，但重复创建Qt窗口的阶段出现Windows原生access violation，不能将本次上传验证描述为完整回归通过。未因此修改用户已调通的业务代码；该测试运行稳定性问题留待排查。
- 本次不烧录固件、不连接板卡，不重新执行液滴、高压、磁杆等实机测试。
- 用户确认当前使用功能全部调通；荧光、加热暂未启用。

## SHA256

| 文件 | SHA256 |
|---|---|
| firmware/prebuilt/Drop_Drive.hex | `5814145F6385214C7B04739C3A046645263392AB490CEF8794C818F805670BE4` |
| host/assets/startup/xiuyun.mp4 | `493DB0FA89D359C45D566116AE99F7B447395AEE50F980D31F07E8A8A192A0C7` |
| host/control.py | `C7299FE065065564A4ADA48F27816ADC3B41FC8B0A916BB146F742E3CCA7972C` |
