zyu43796-byte/Microfluidic-device/hardware/Drop_Board/板4PCB_V1/Main_board4.pdf

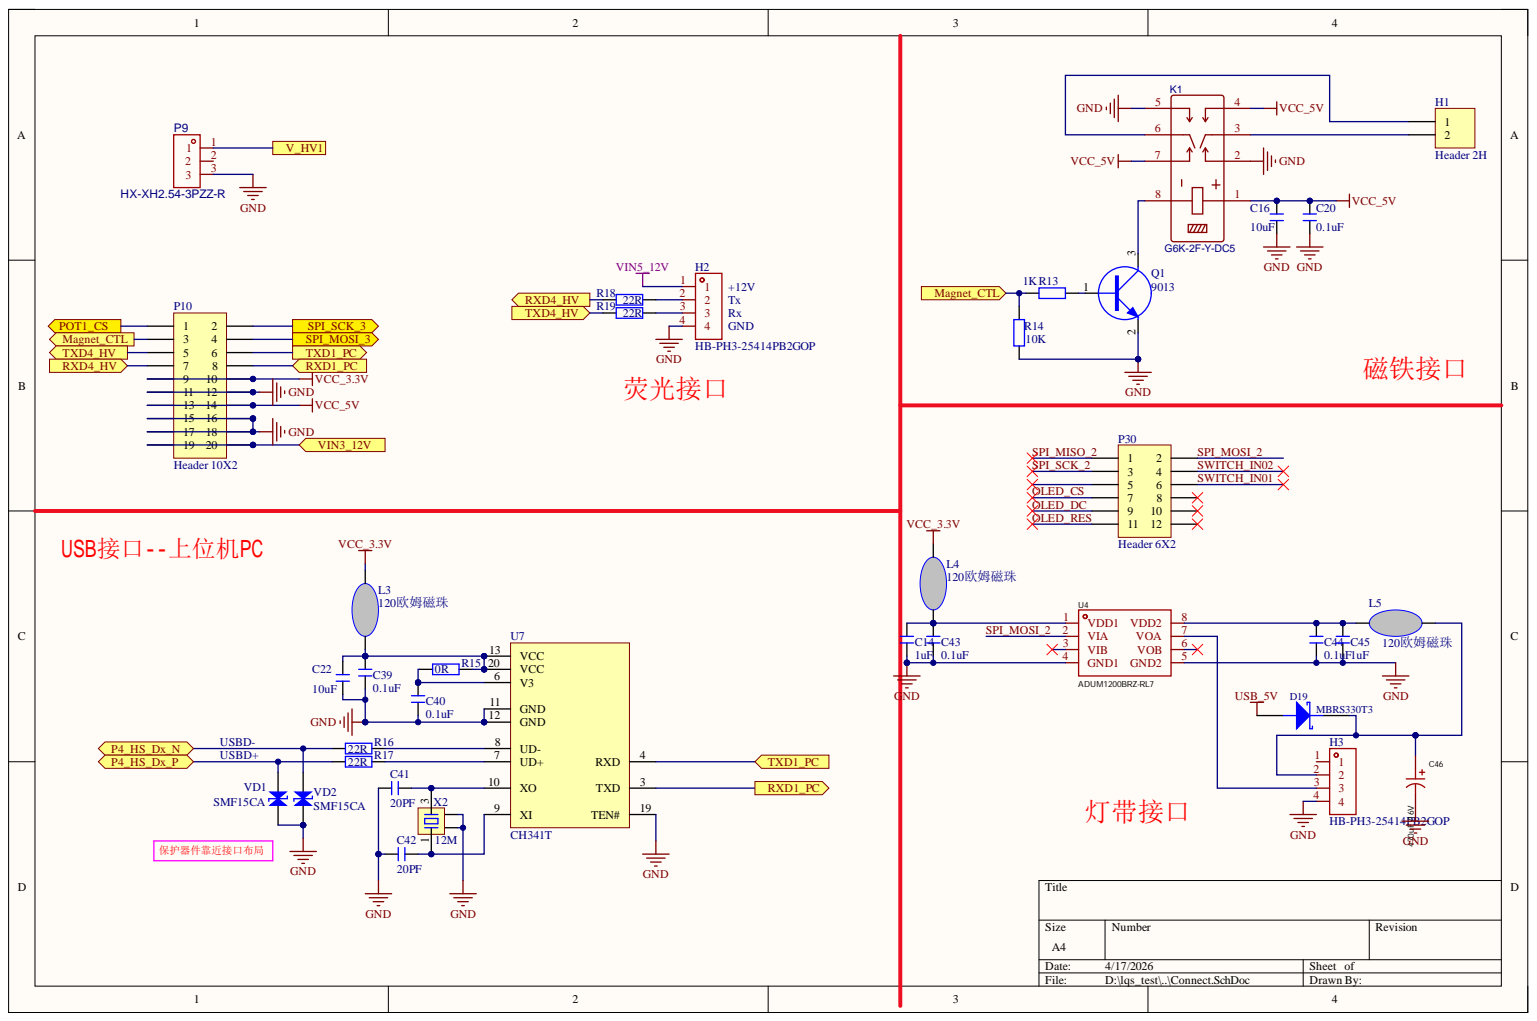
[picture p5: page 1]

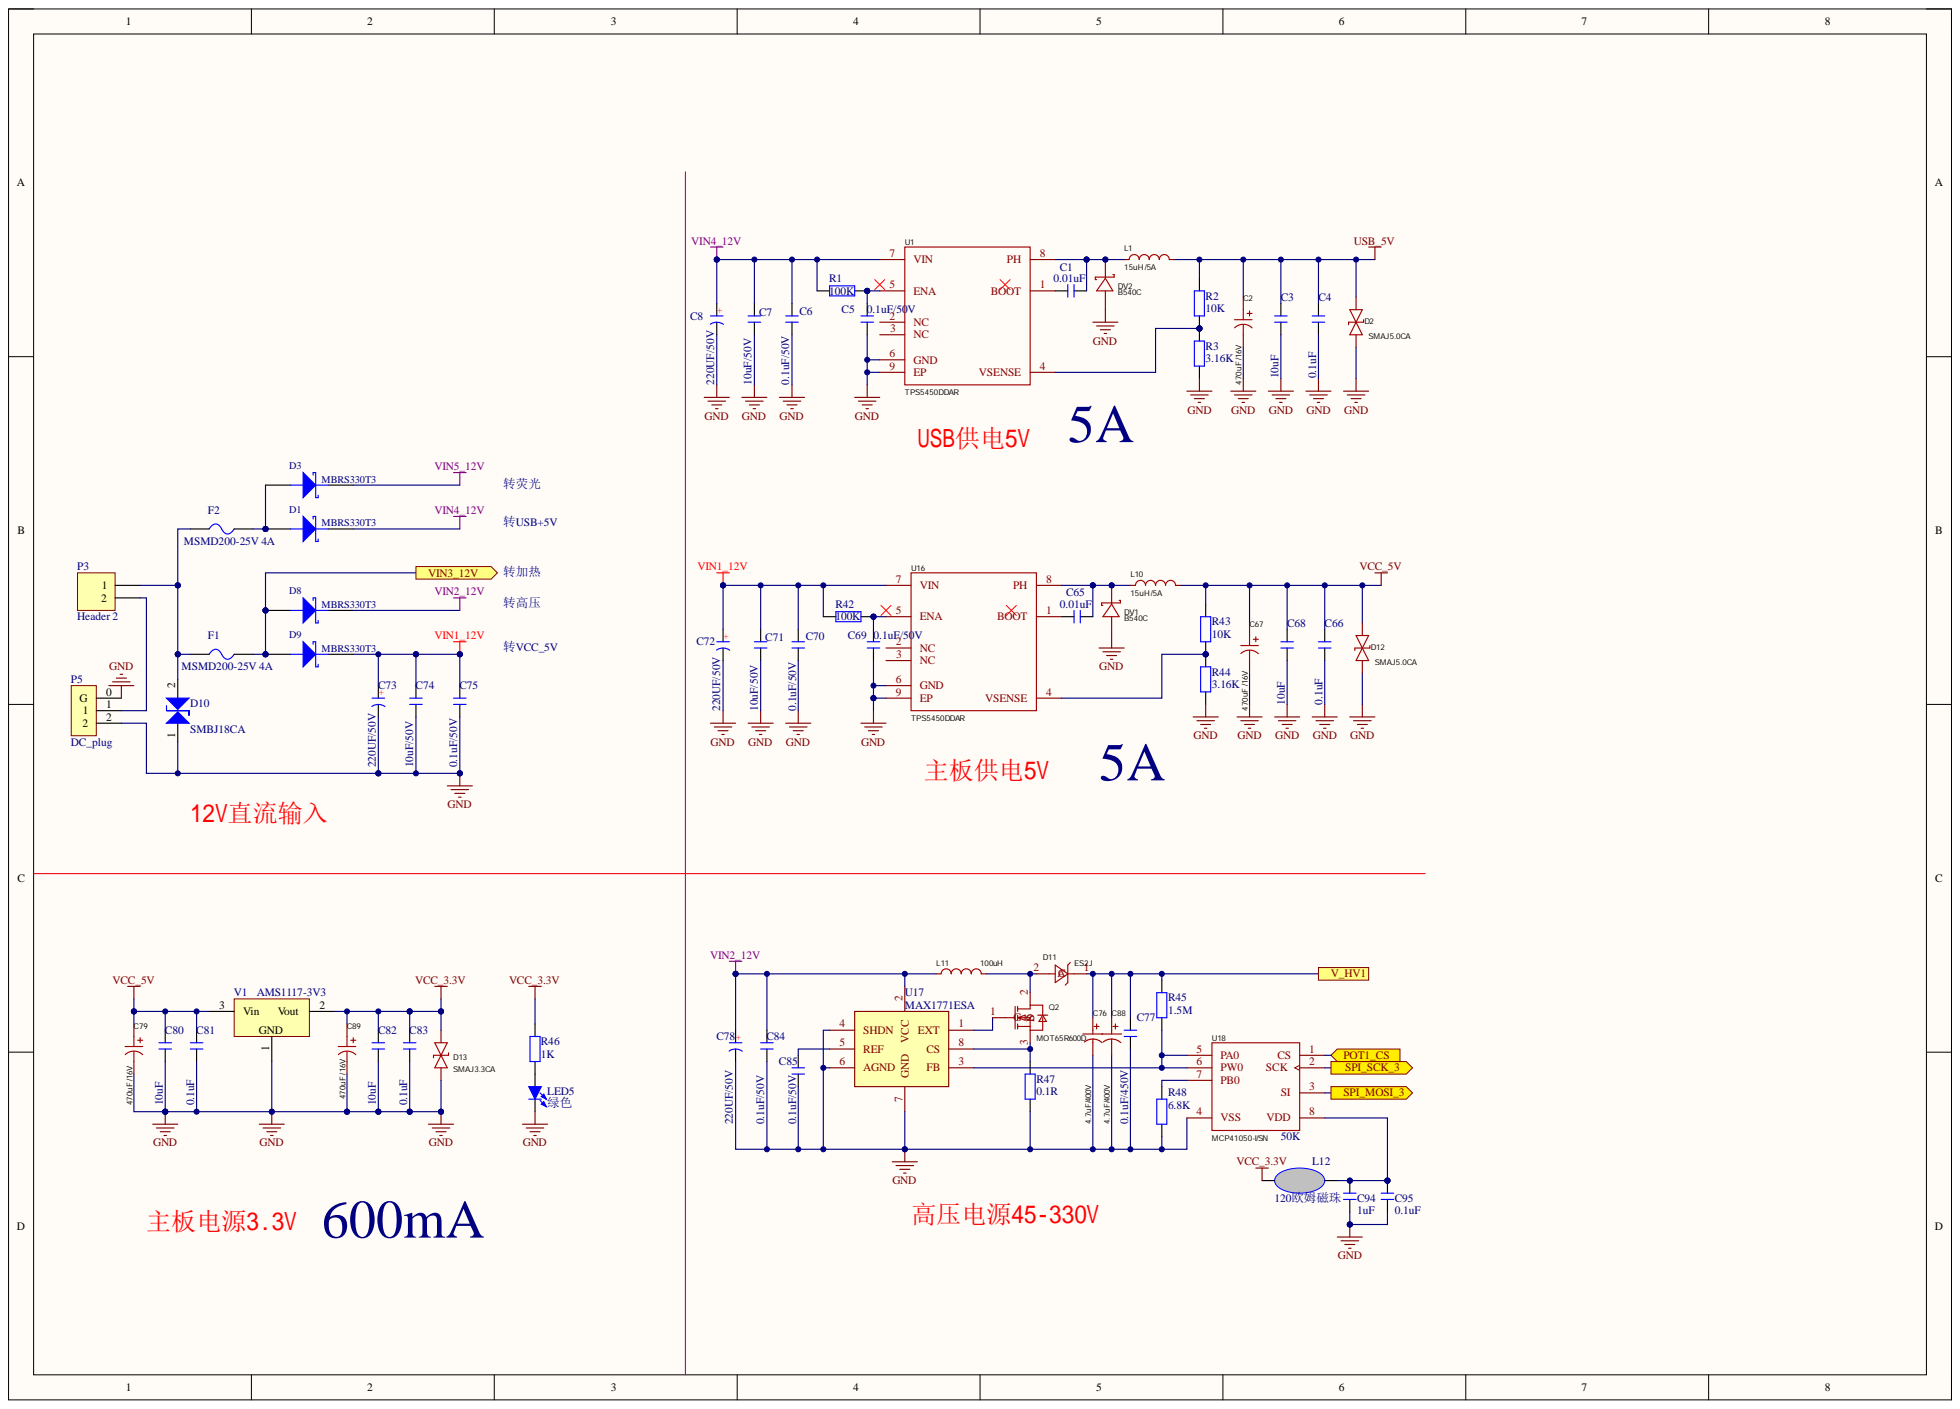
[picture p6: page 2]

AGND 6 | PB0 7

VSS 4

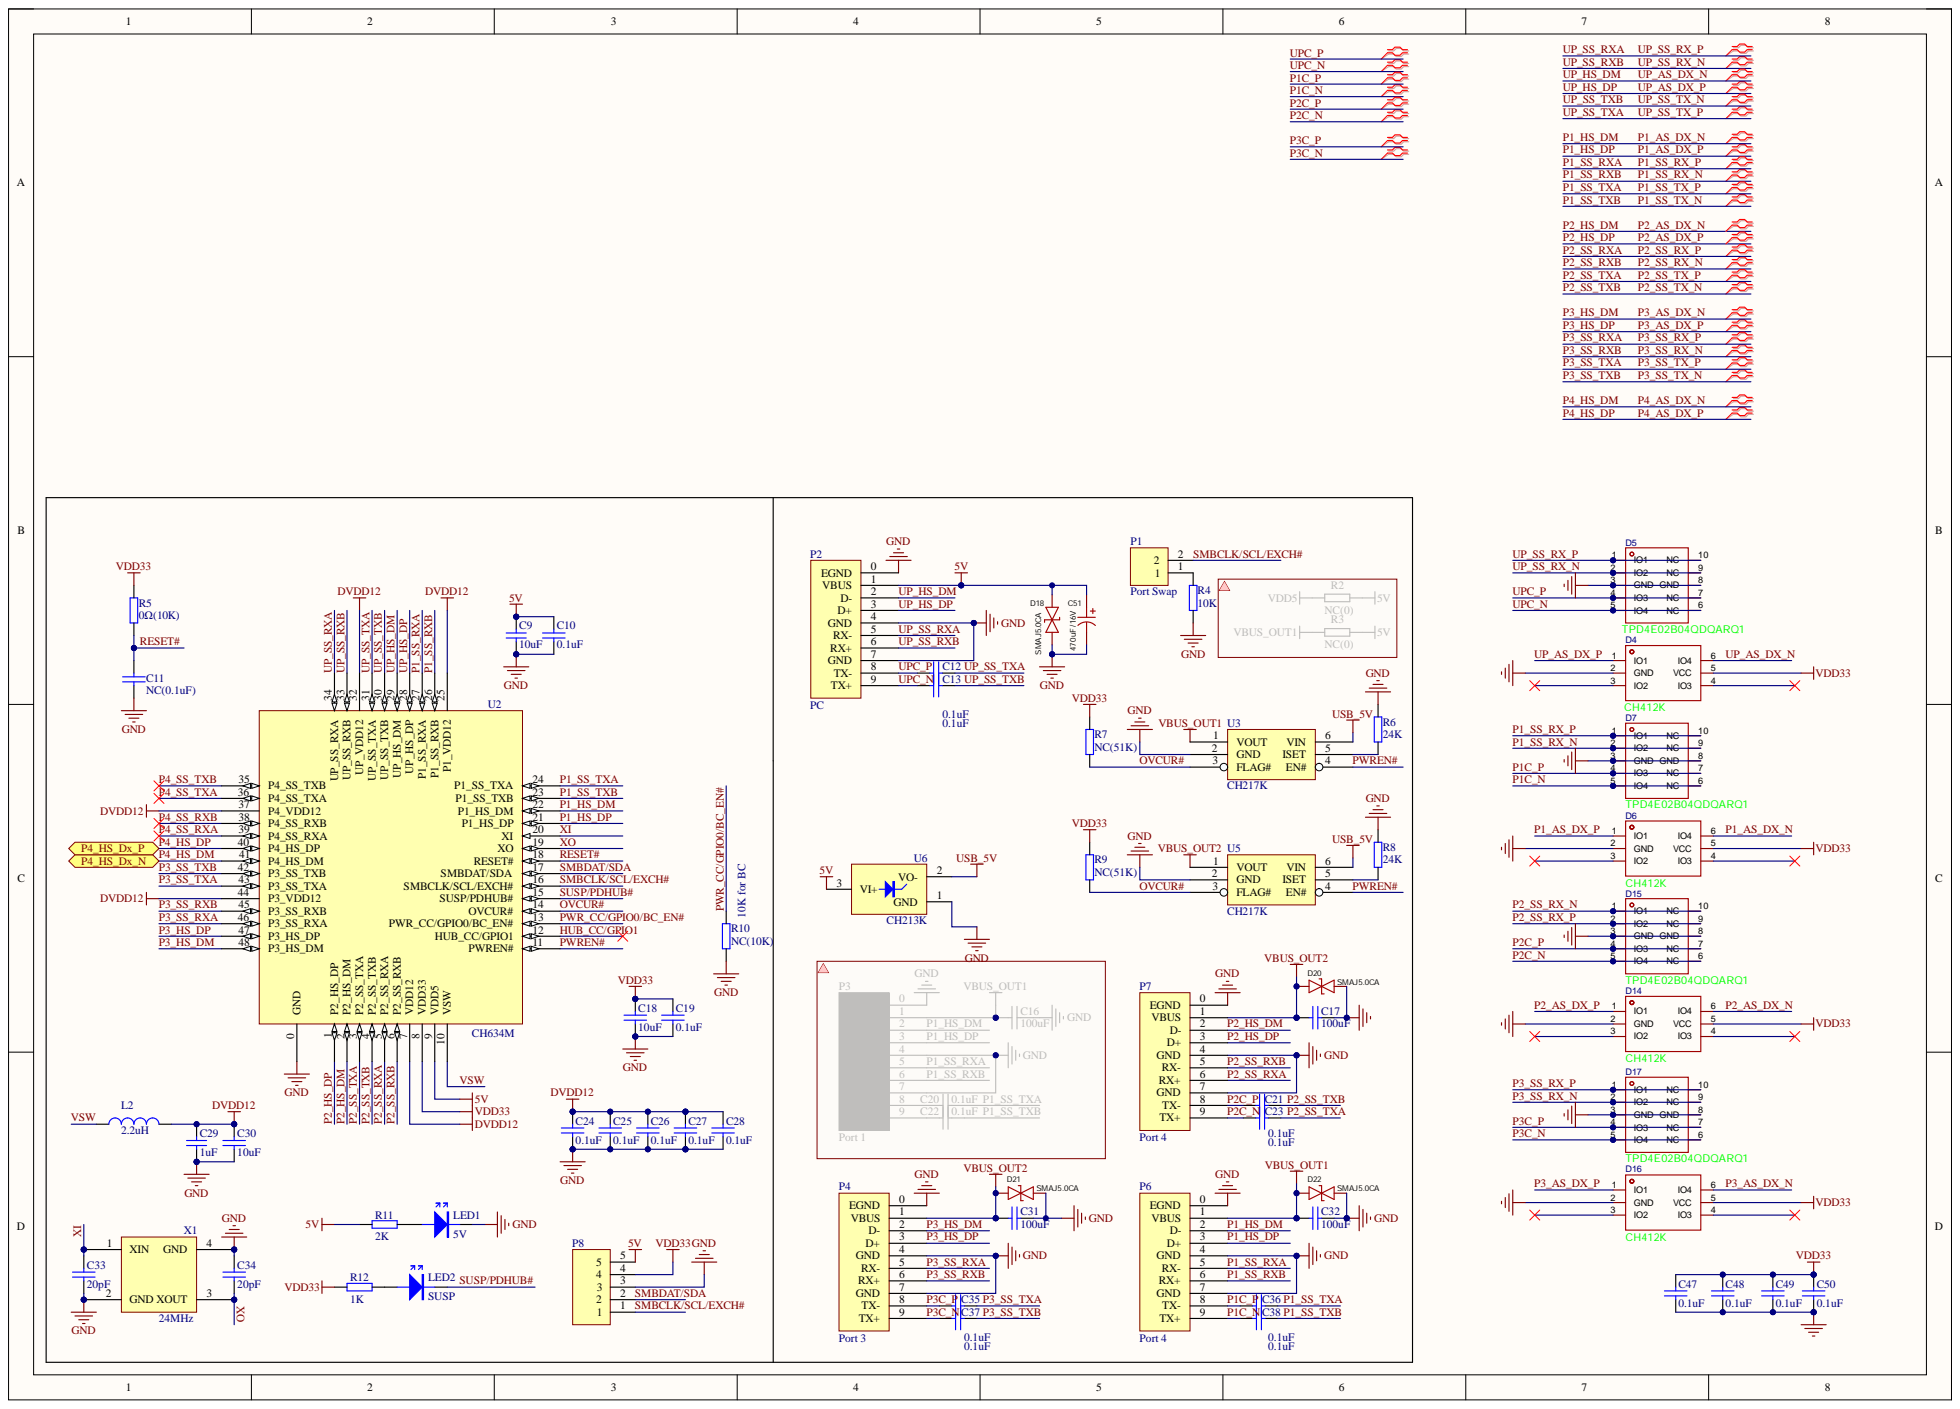
[picture p7: page 3]

GND 3
IO3 4

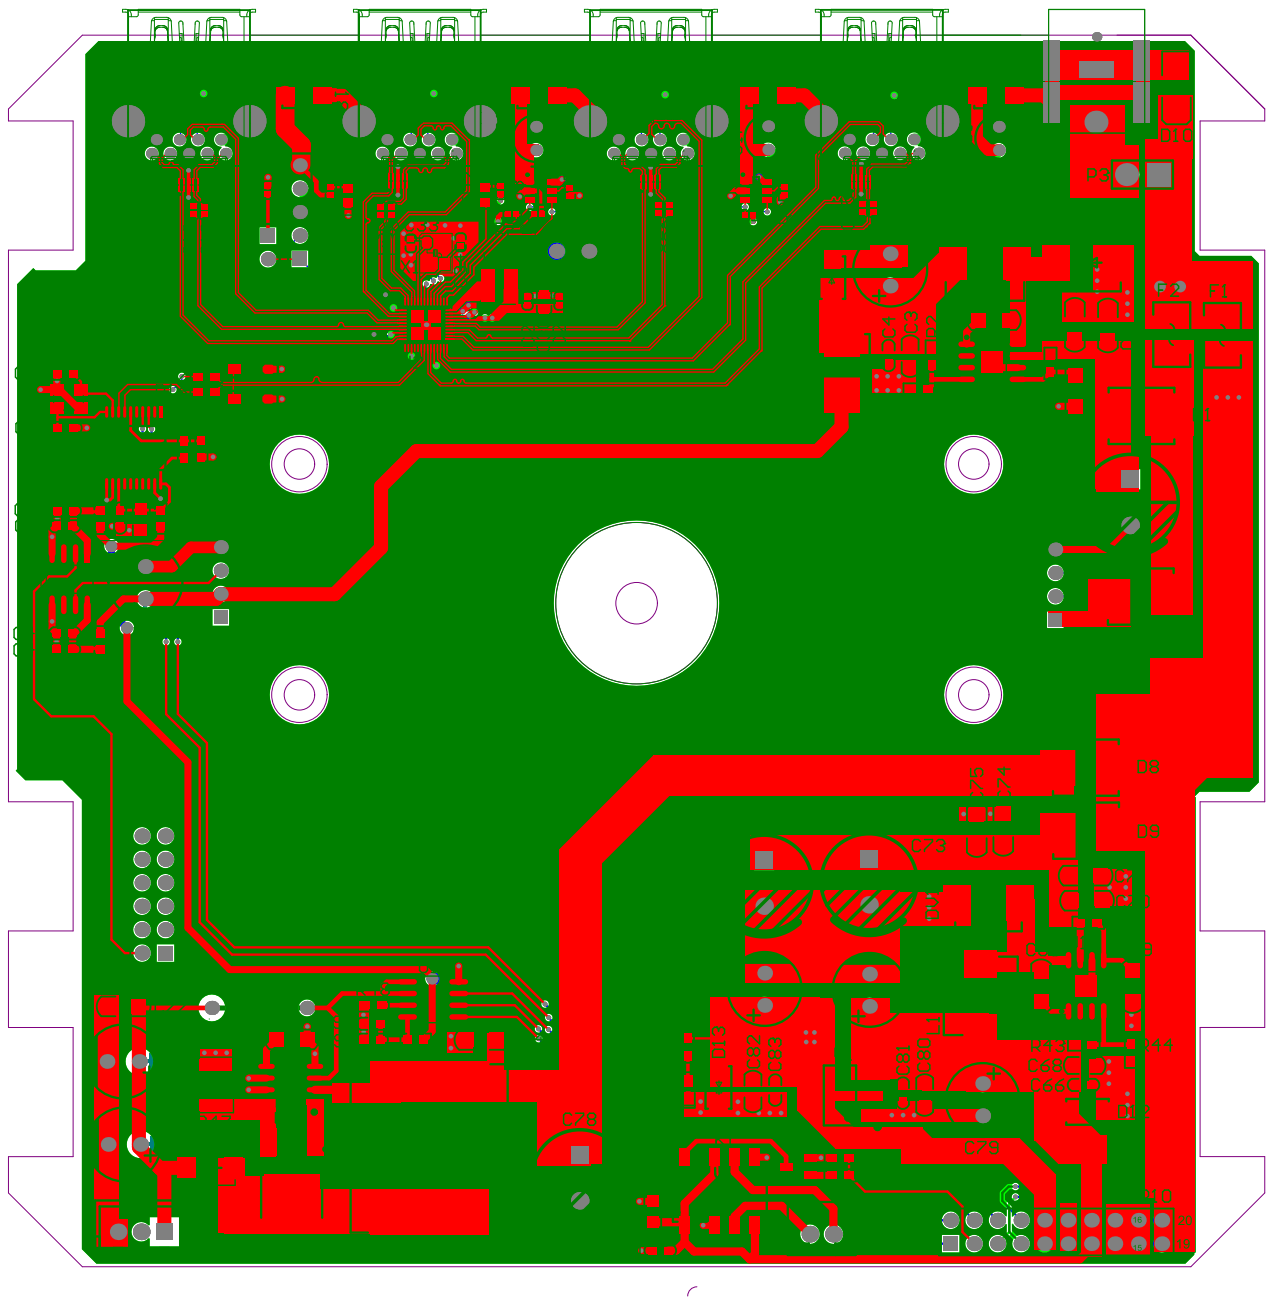
[picture p8: page 4]
