zyu43796-byte/Microfluidic-device/hardware/Drop_Board/板1PCB_V1/Main_board1.pdf

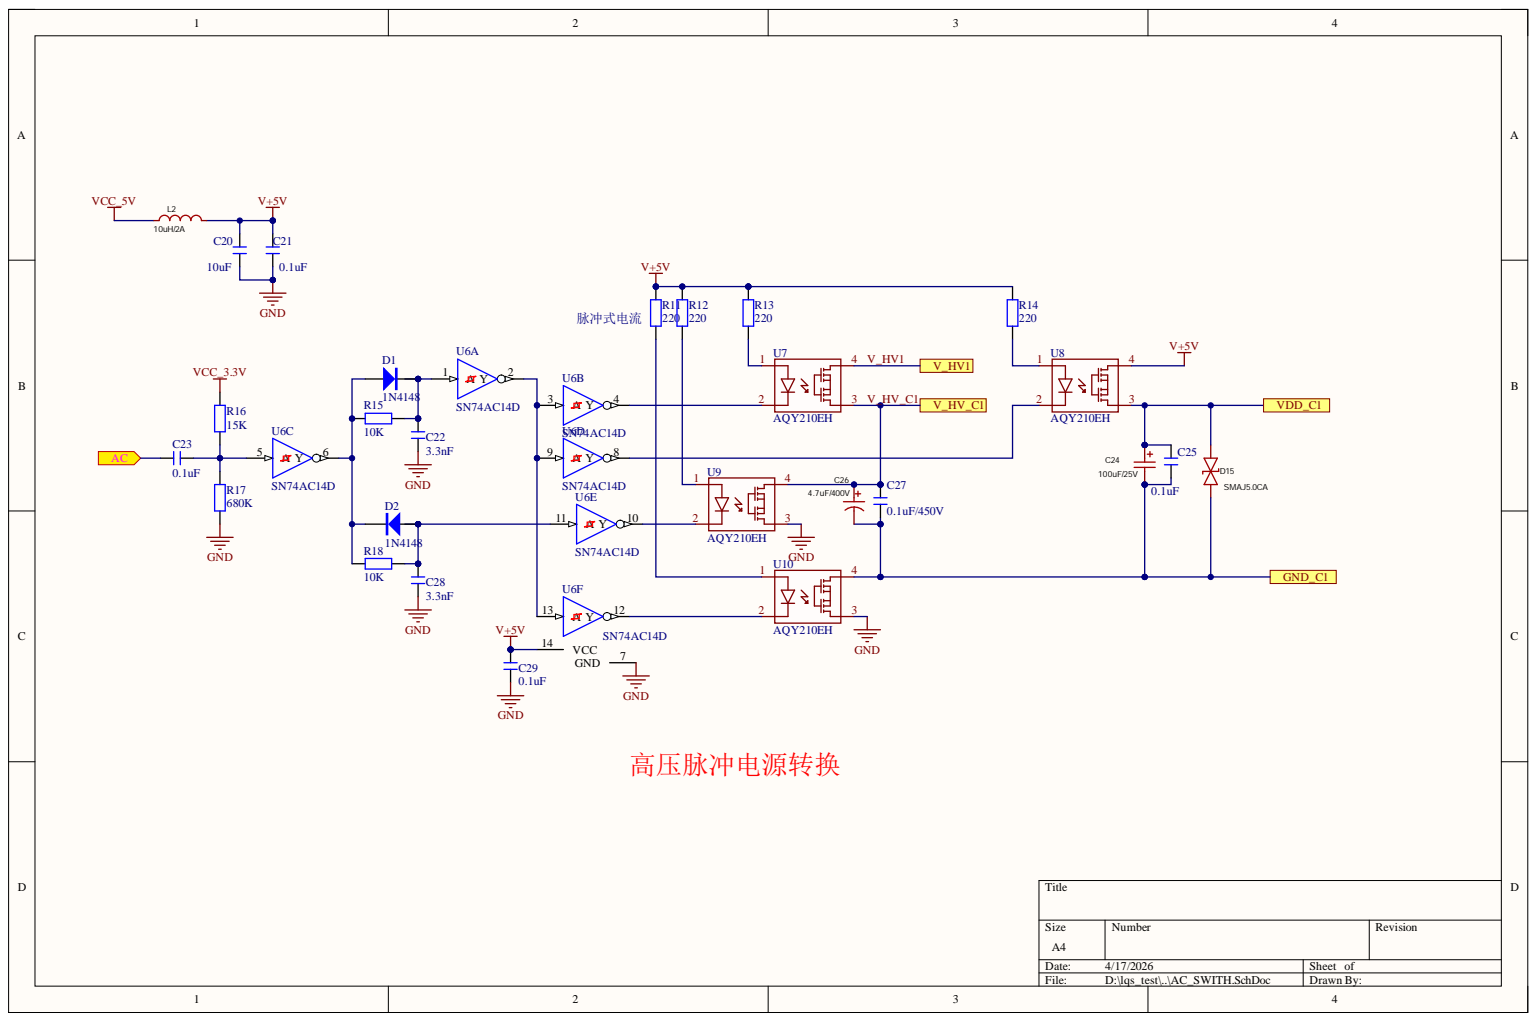
[picture p9: page 1]

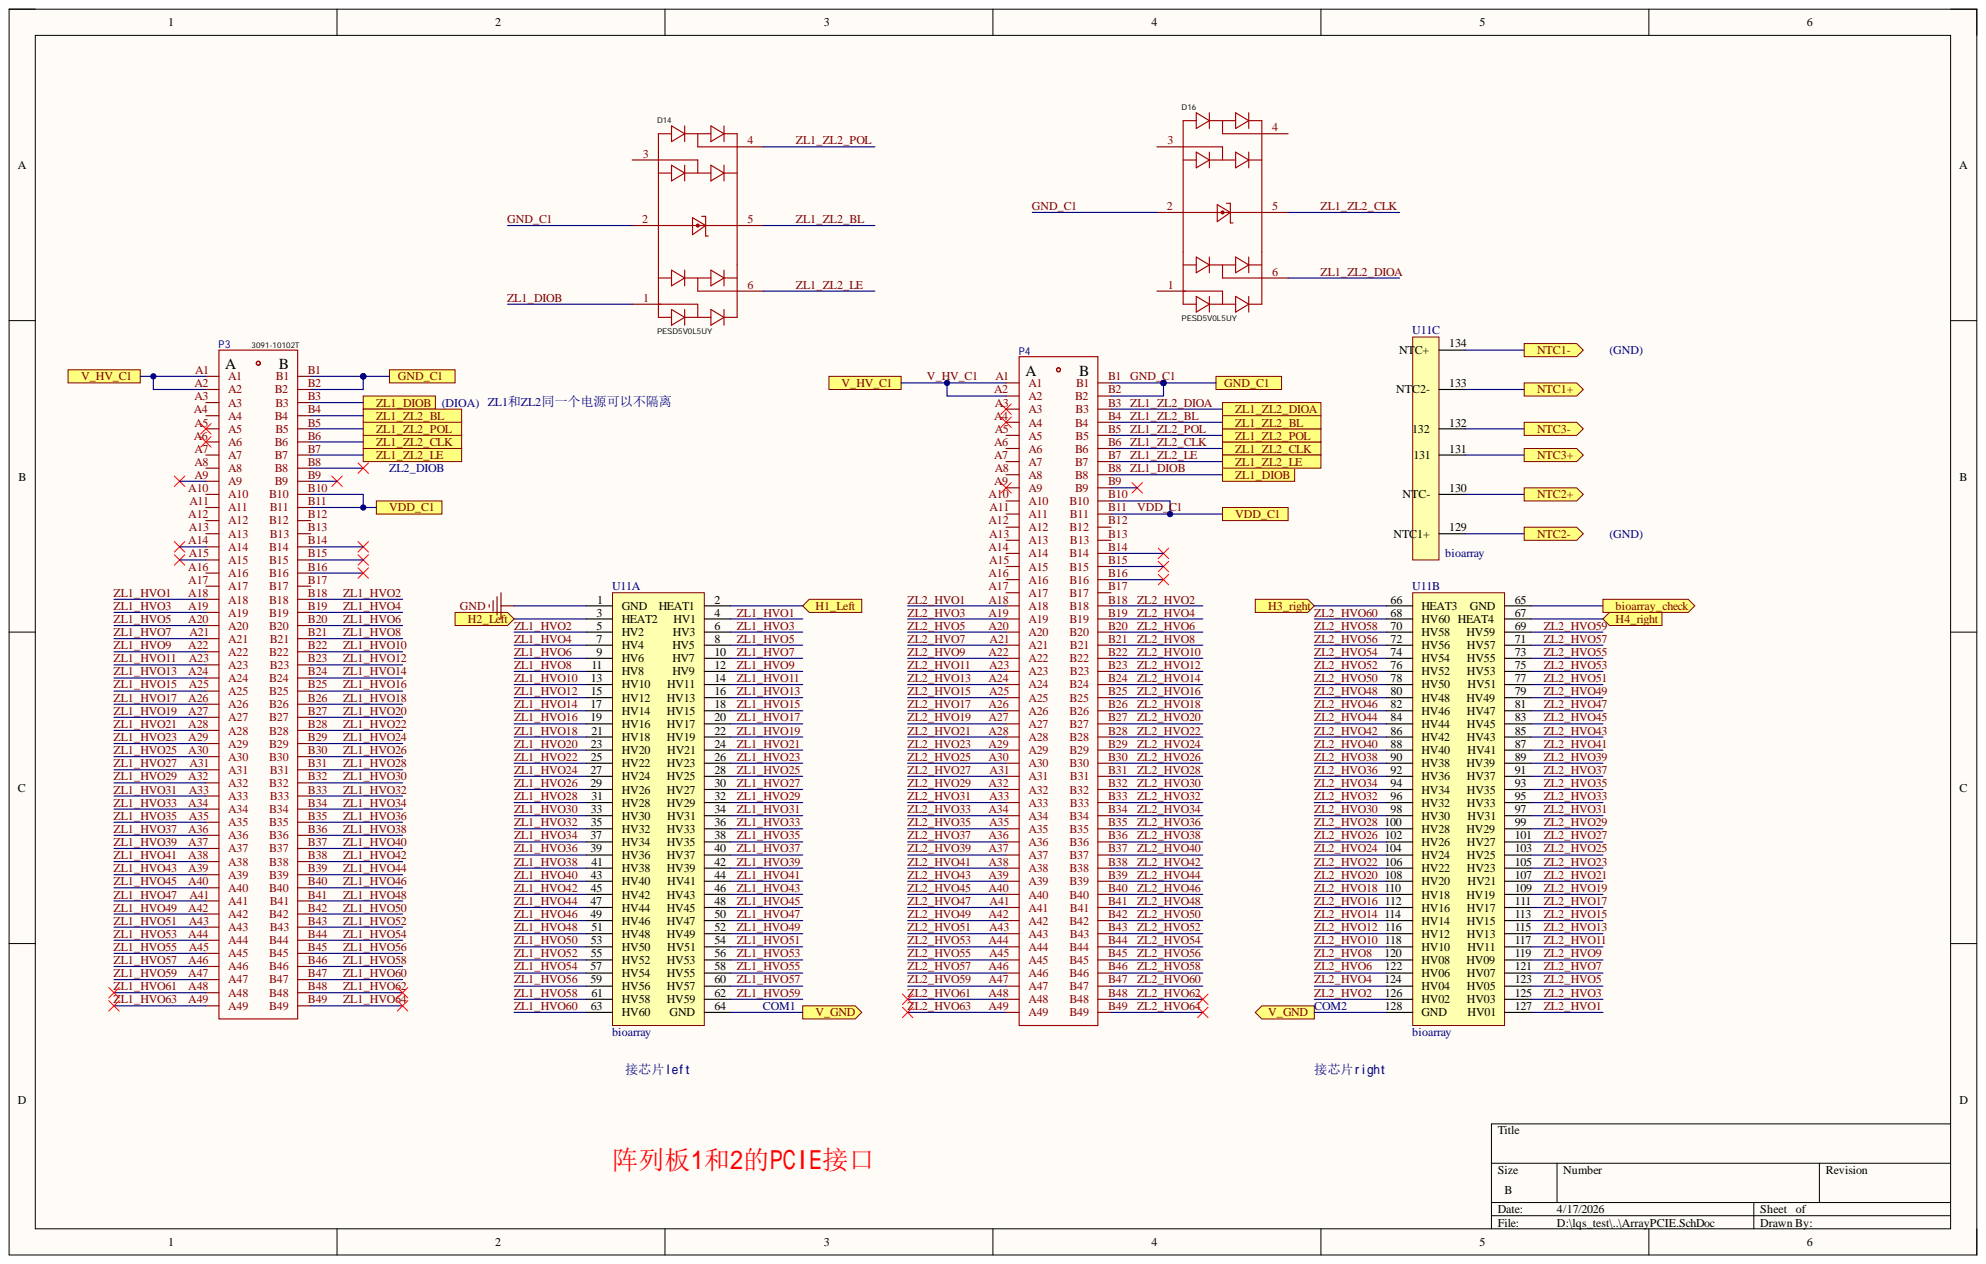
[picture p10: page 2]

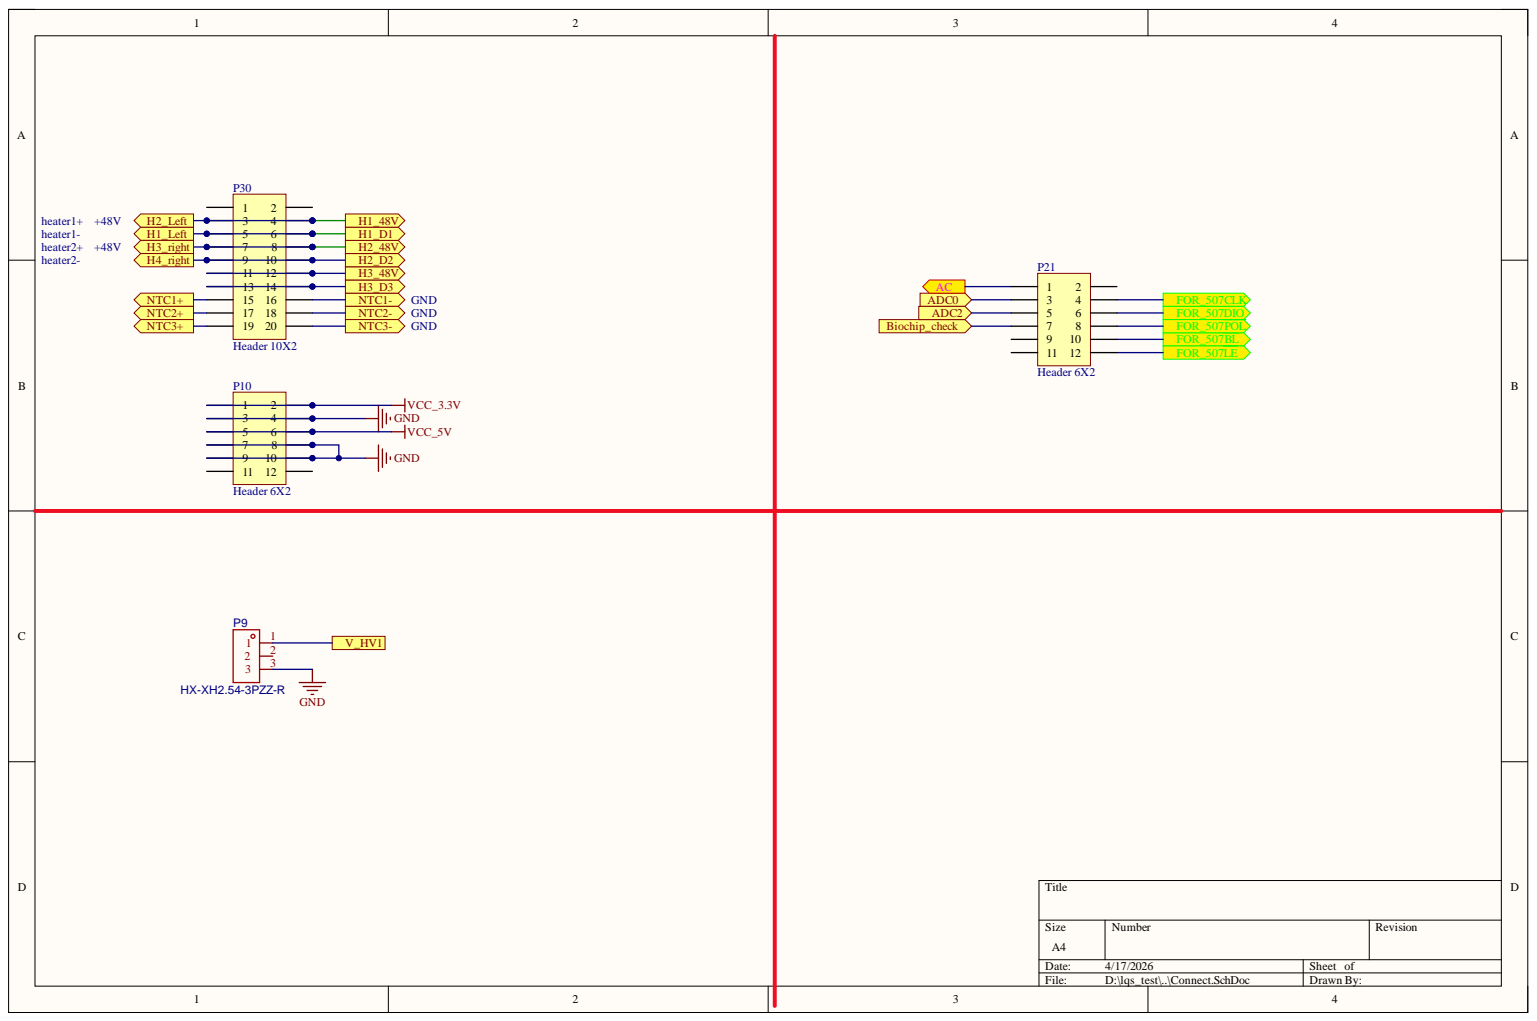
[picture p11: page 3]

5 6
7 8
9 10 11 12

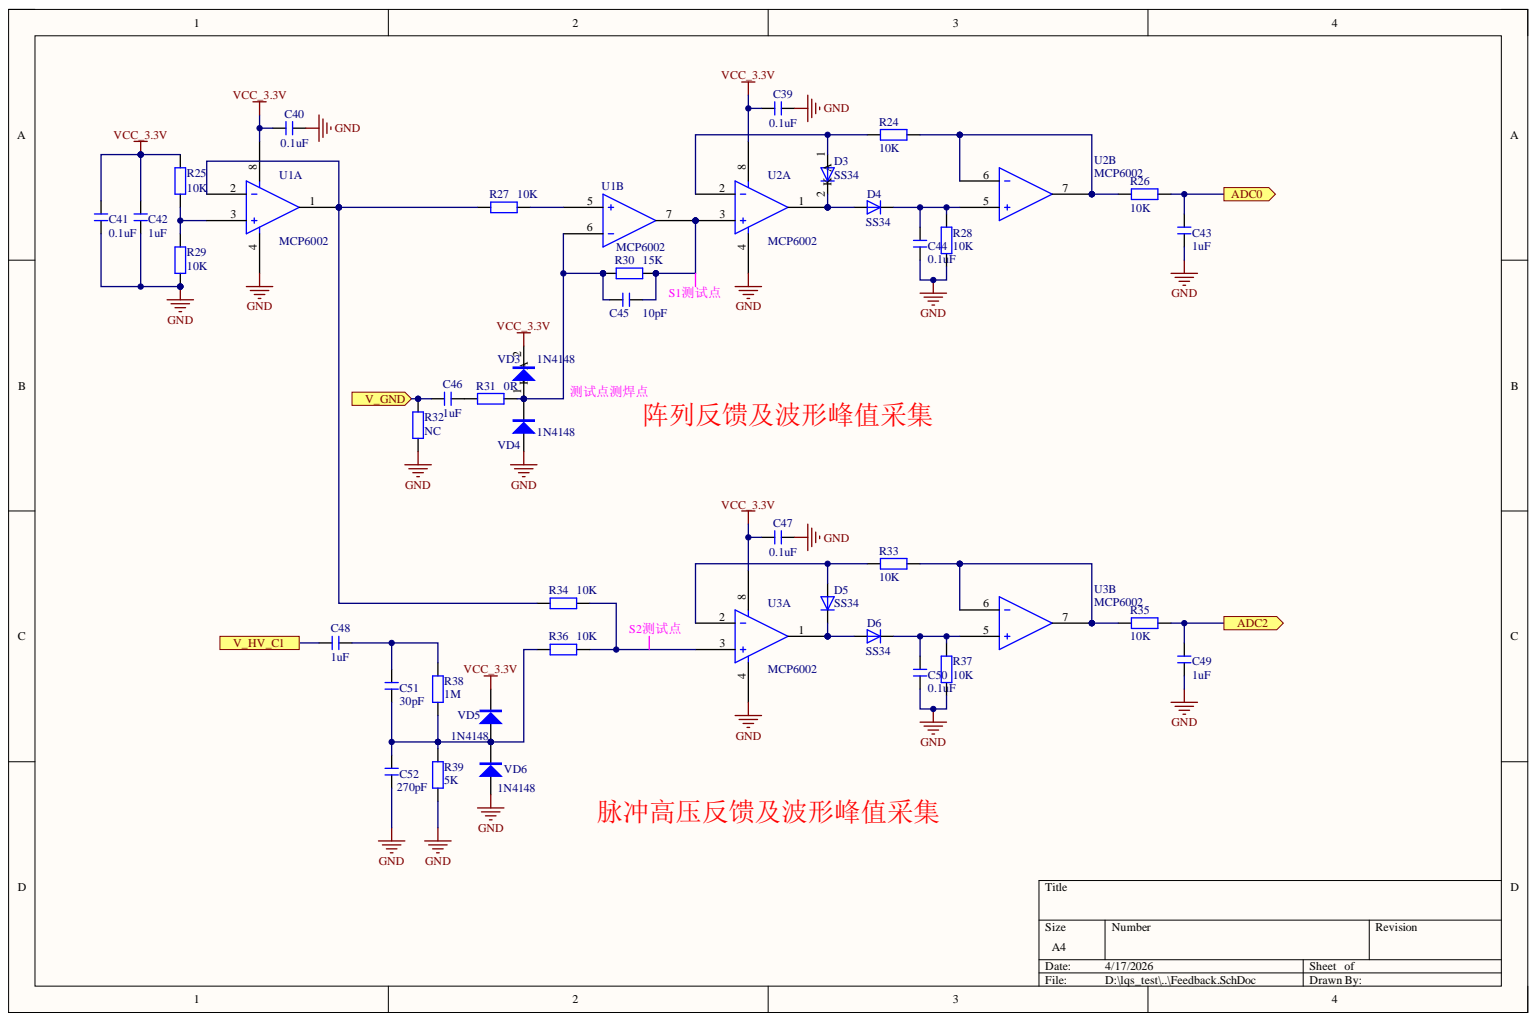
[picture p12: page 4]

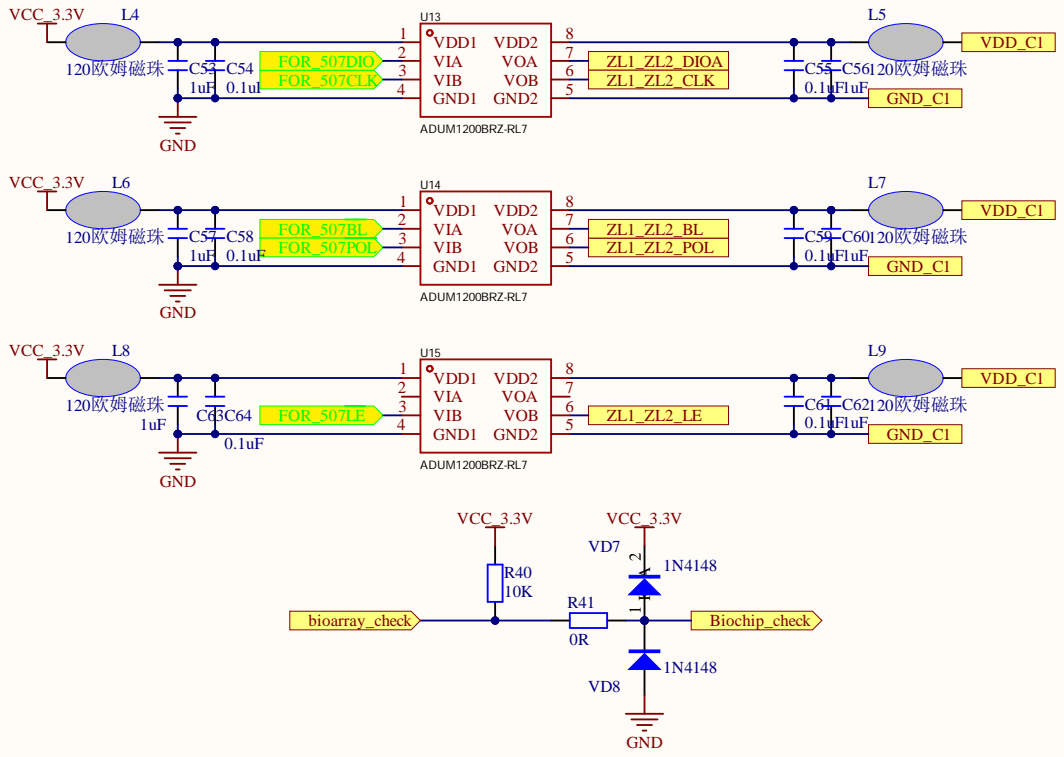
[picture p13: page 5]

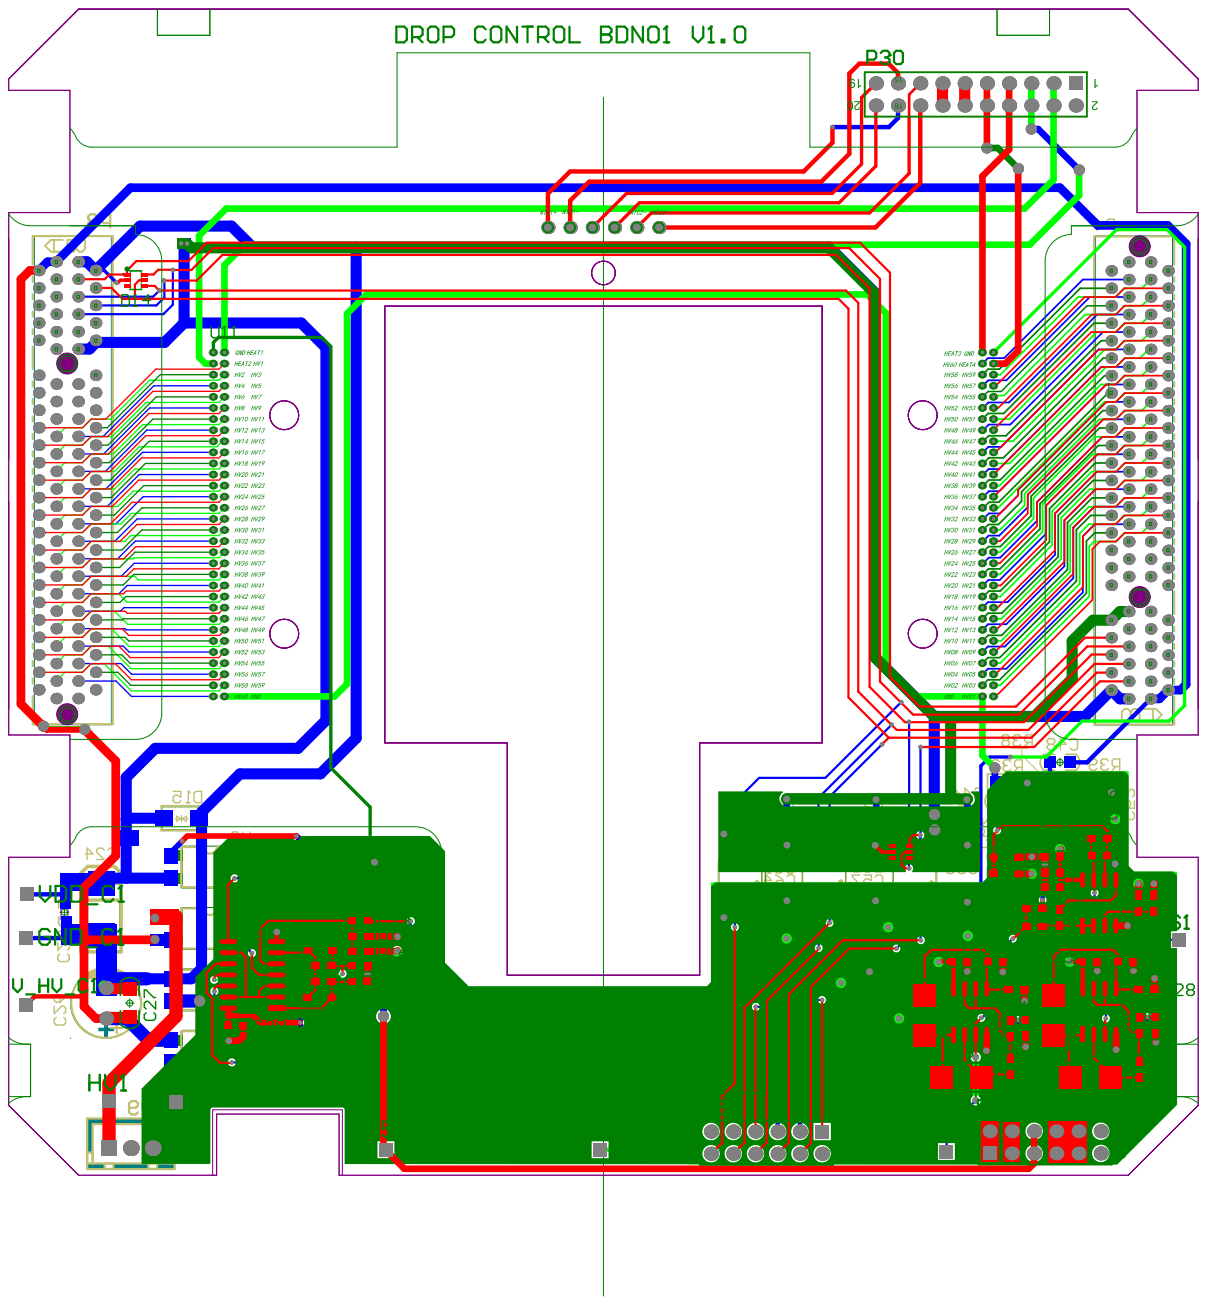
[picture p14: page 6]
