zyu43796-byte/Microfluidic-device/hardware/Drop_Board/板2PCB_V1/Main_board2.pdf

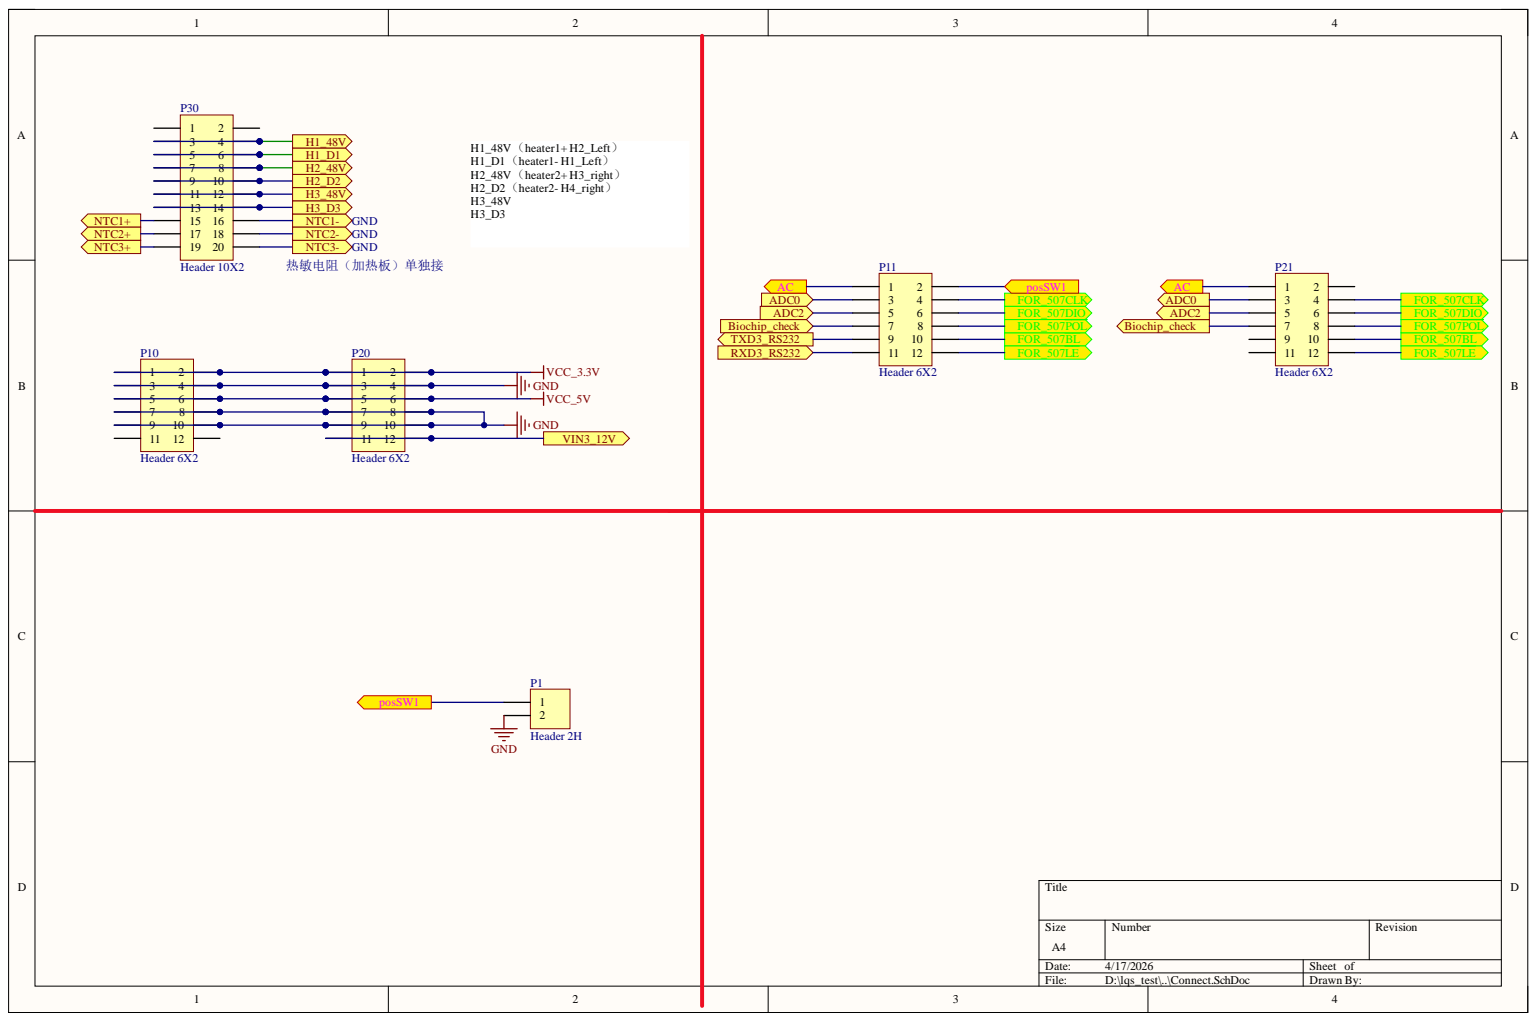
[picture p15: page 1]

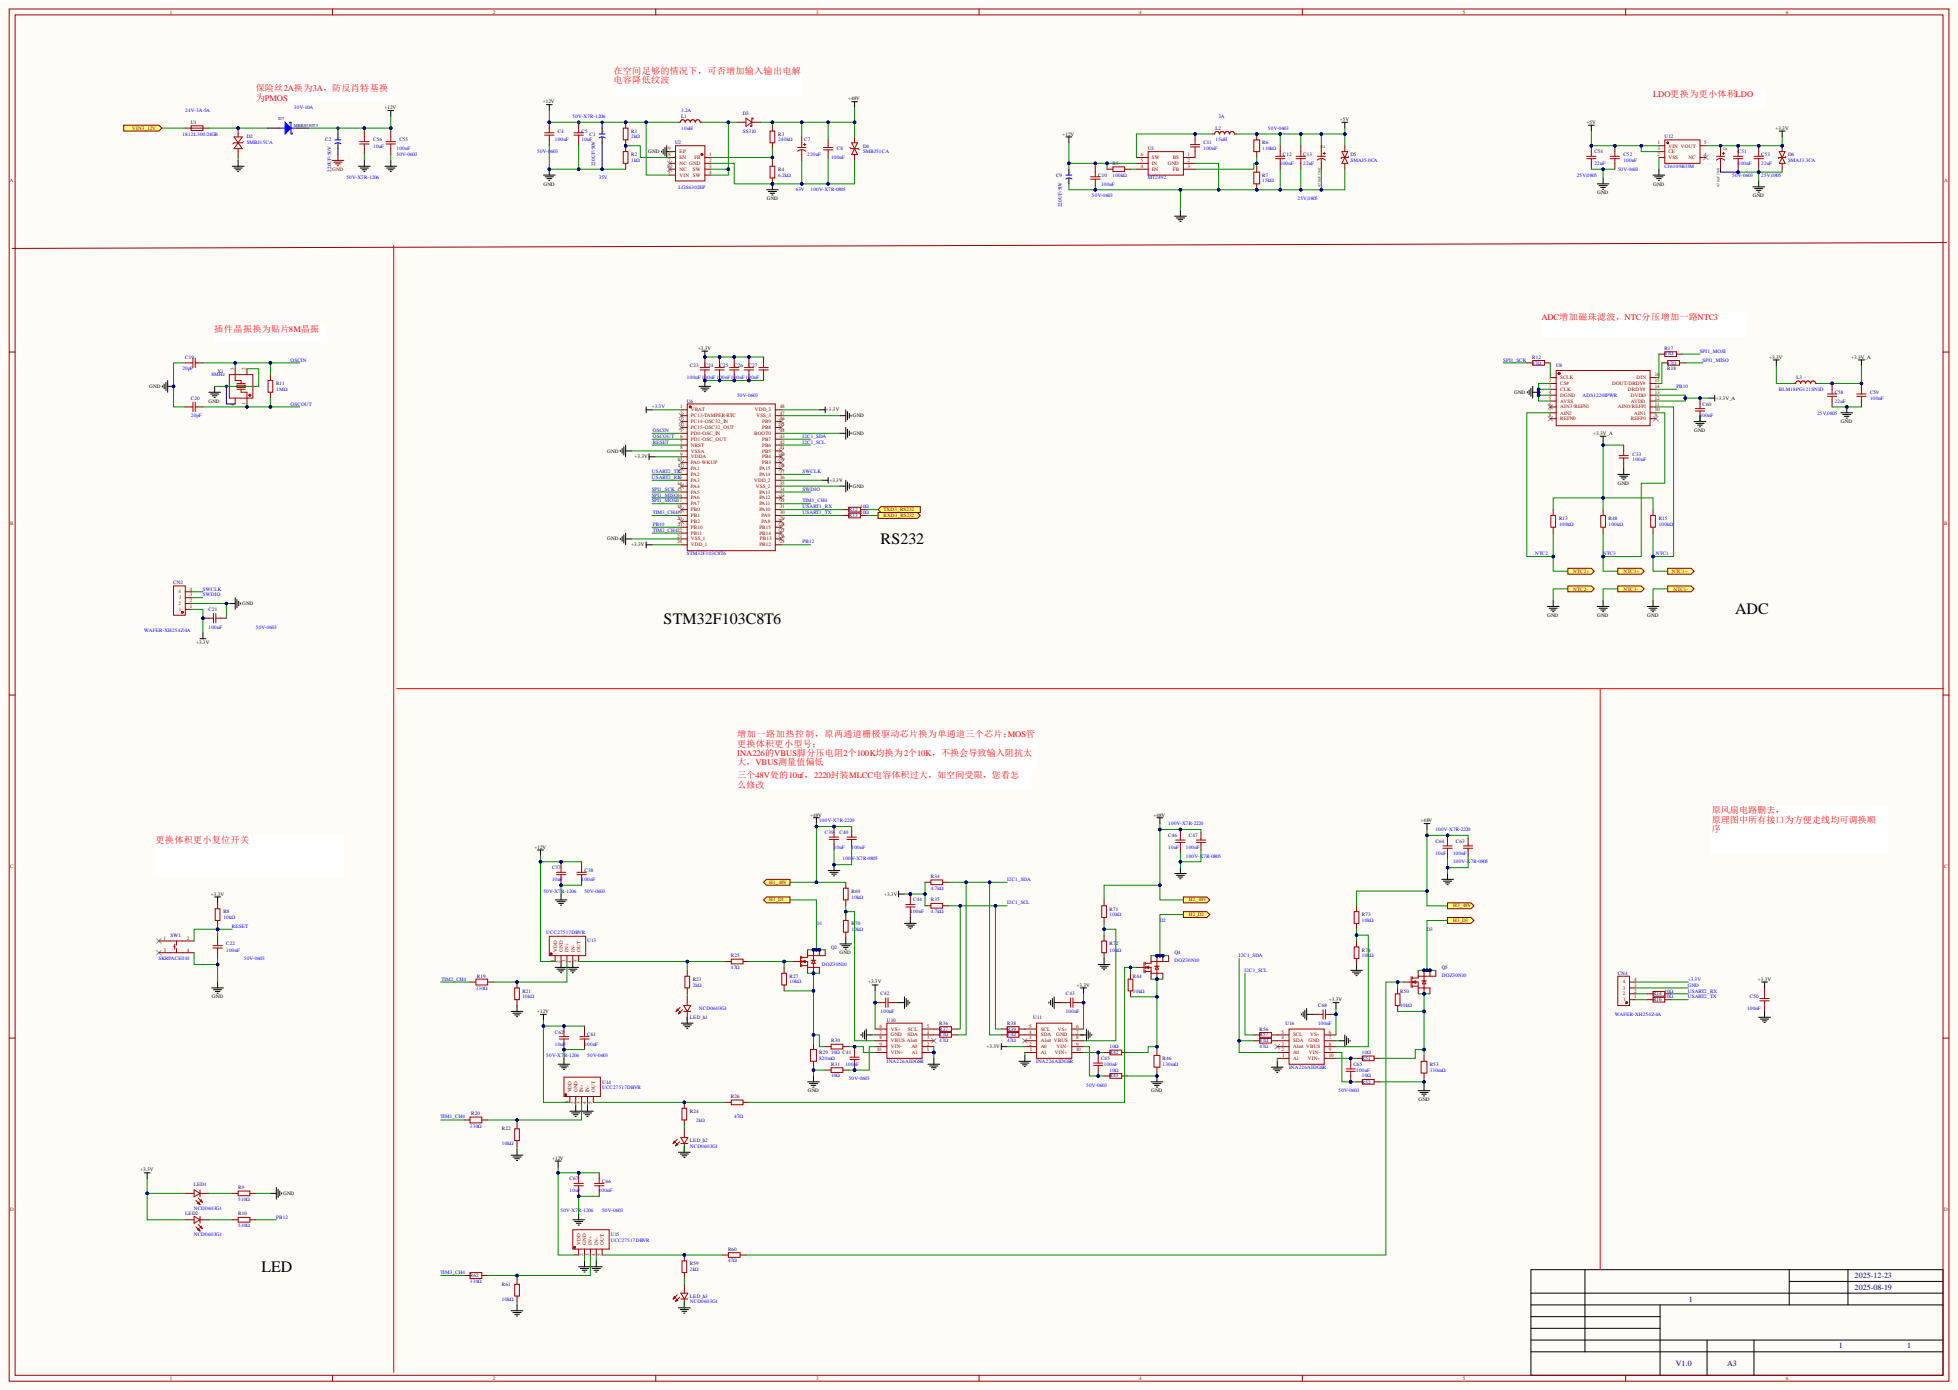
[picture p16: page 2]

2025-12-23
2025-08-19

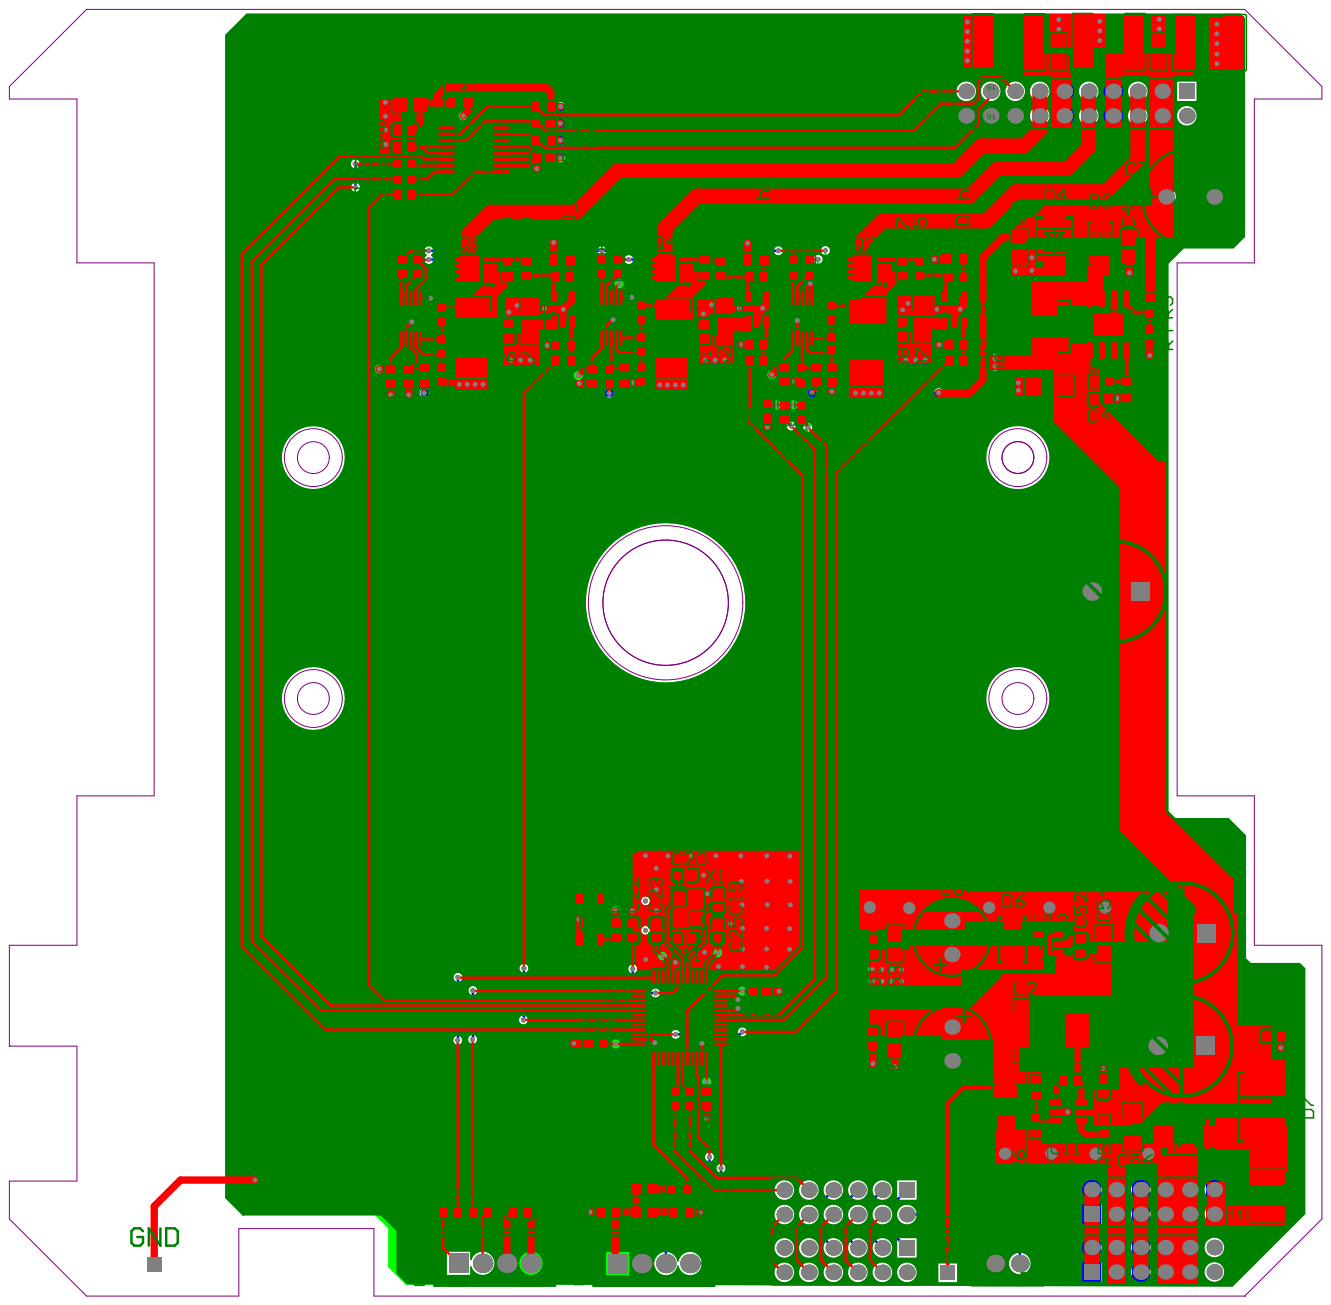
[picture p17: page 3]
