zyu43796-byte/Microfluidic-device/hardware/Drop_Board/板3PCB_V1/Main_board3.pdf

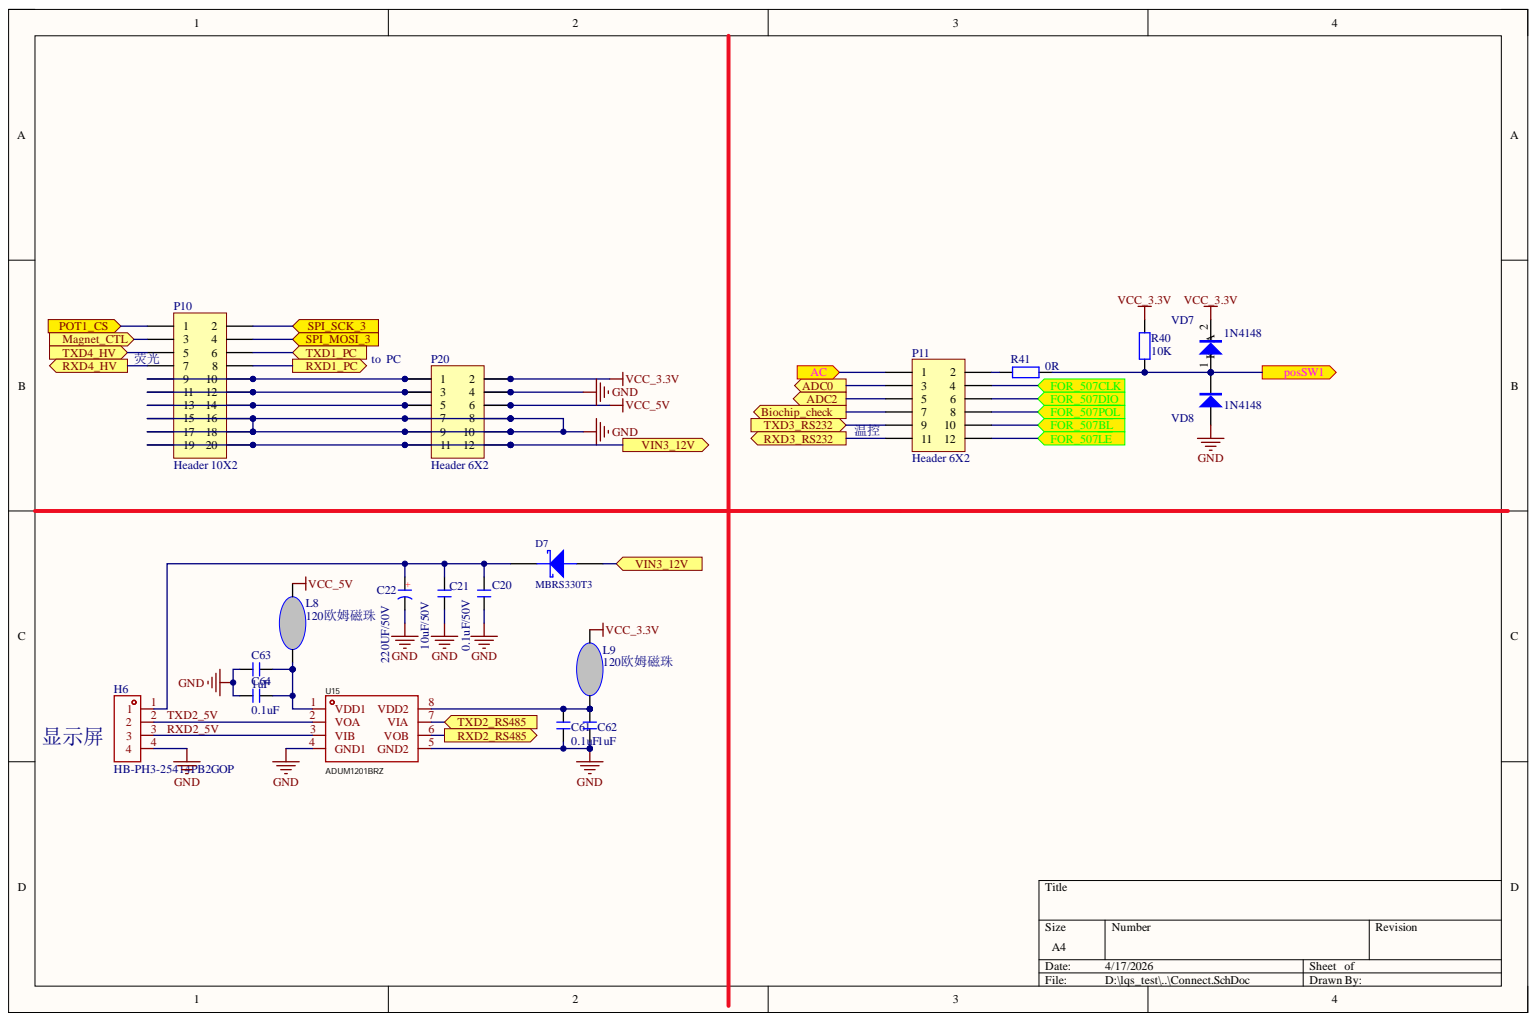
[picture p18: page 1]

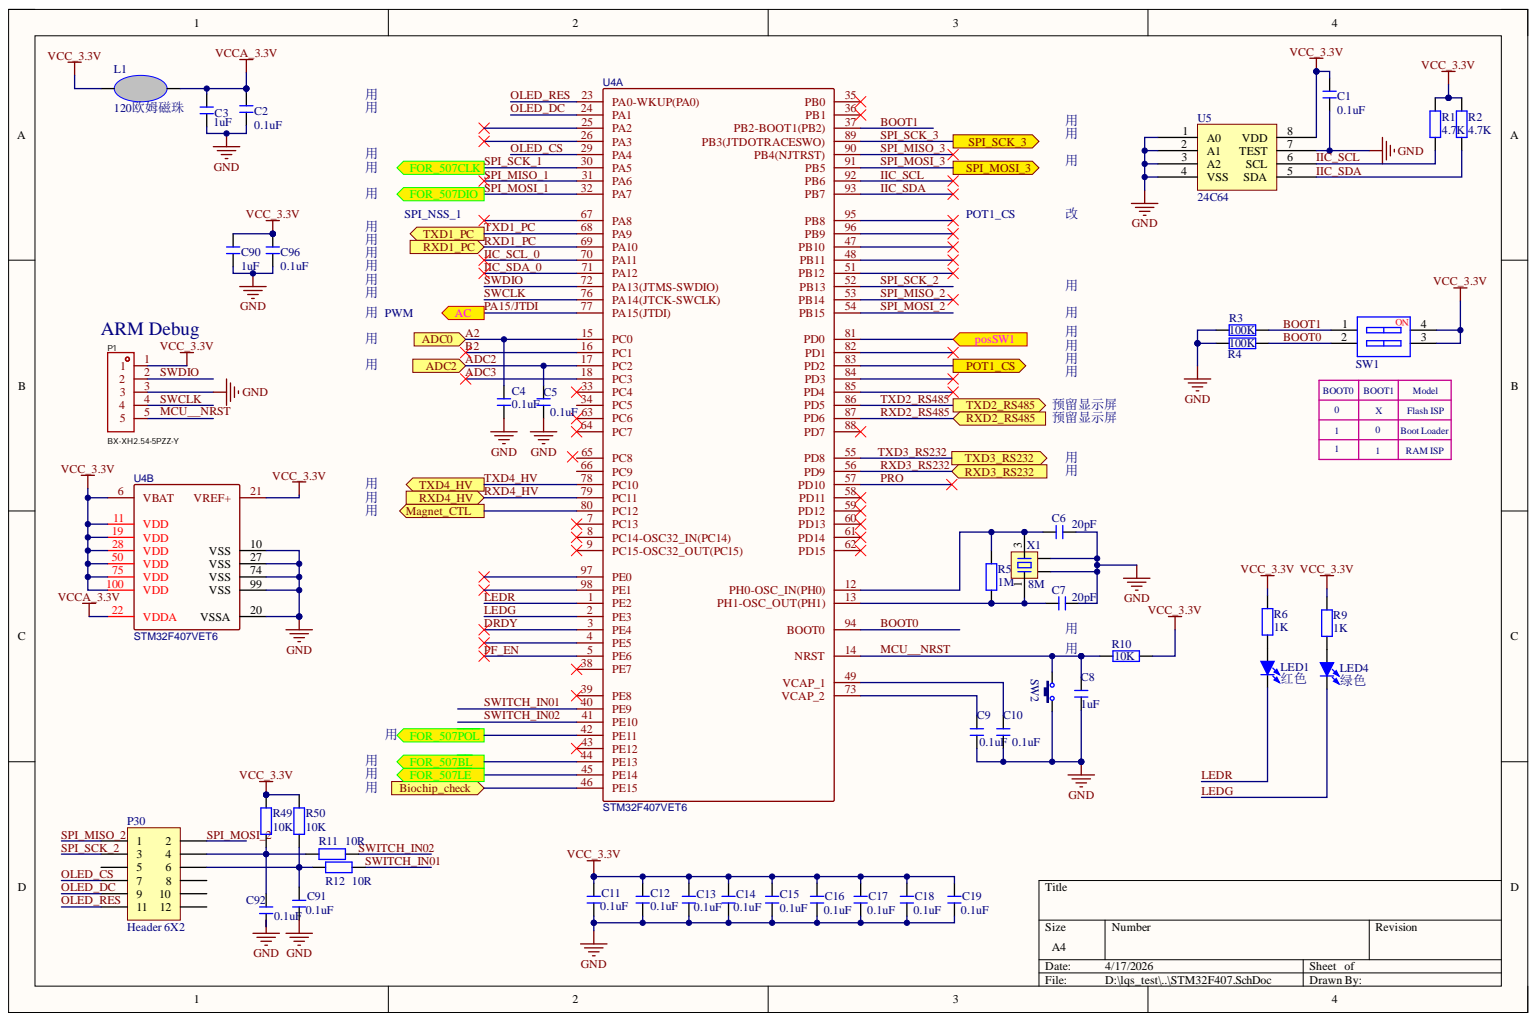
[picture p19: page 2]

A1 2
A2 3 | IIC_SCL

0 | X | Flash ISP

1 | 0 | Boot Loader

1 | 1 | RAM ISP

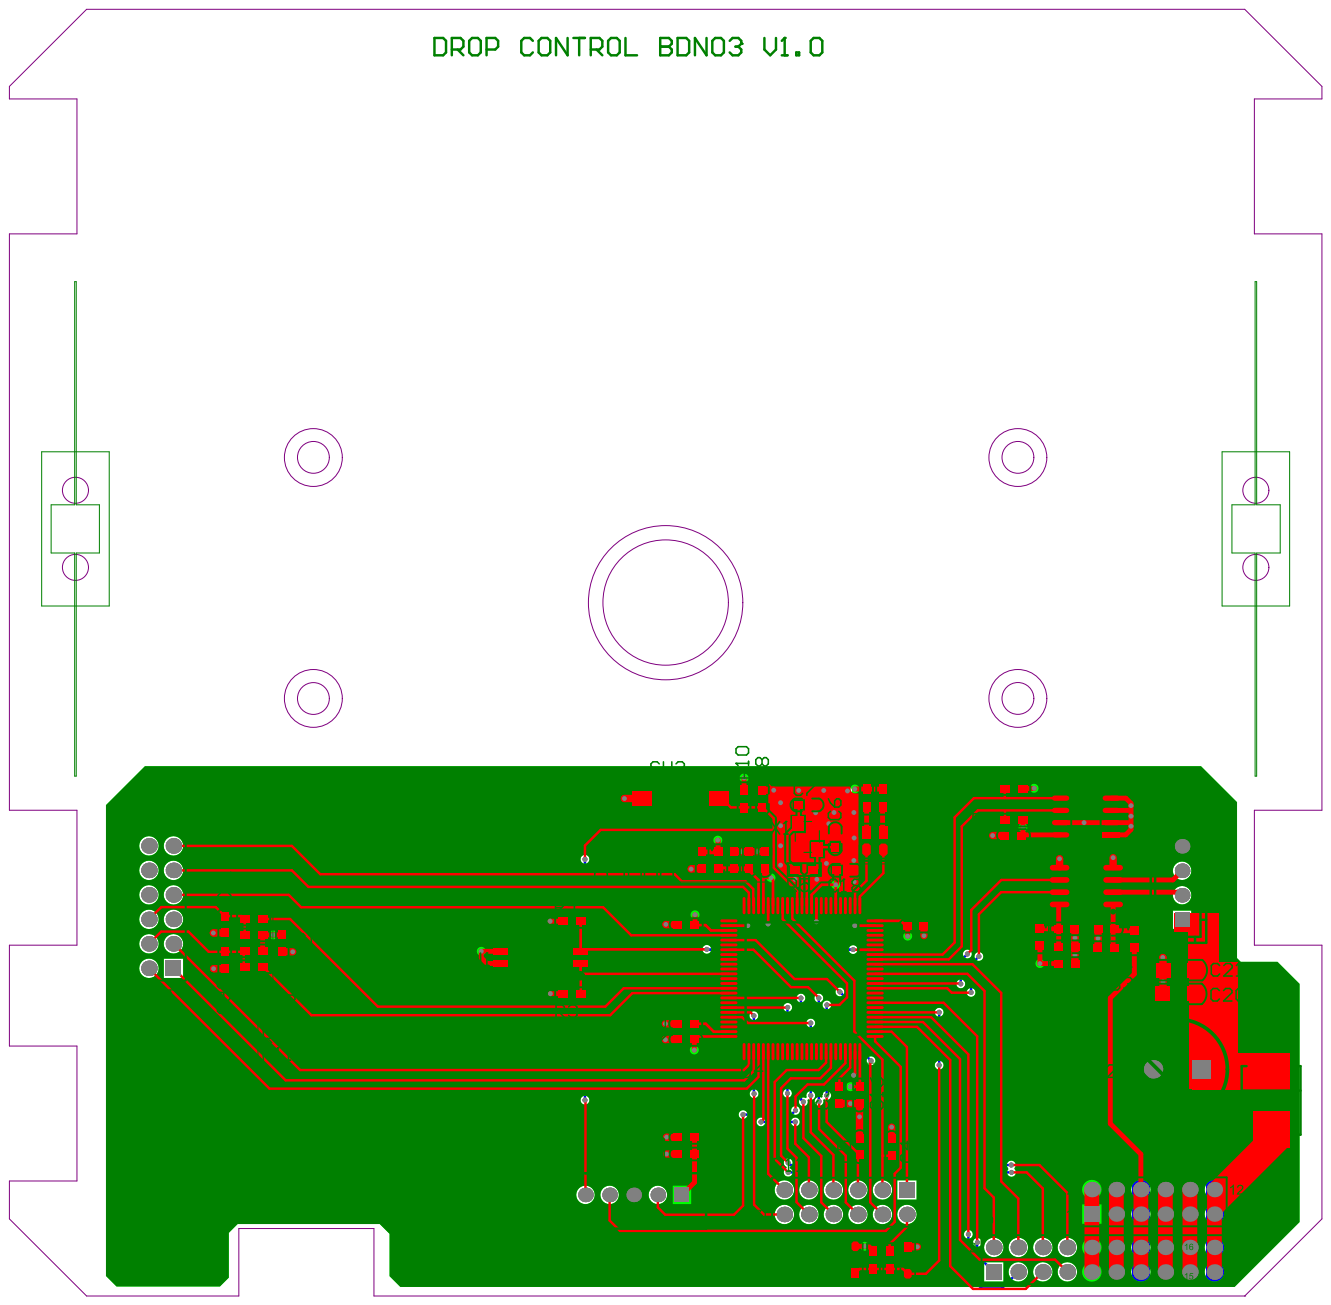
[picture p20: page 3]
