zyu43796-byte/Microfluidic-device/(list of files, drawings)

Other design files:
hardware/Drop_Board/板1PCB_V1/AC_SWITH.SchDoc
hardware/Drop_Board/板1PCB_V1/ArrayPCIE.SchDoc
hardware/Drop_Board/板1PCB_V1/BD1_yd_V1.0.PcbDoc
hardware/Drop_Board/板1PCB_V1/Connect.SchDoc
hardware/Drop_Board/板1PCB_V1/Feedback.SchDoc
hardware/Drop_Board/板1PCB_V1/ISO_signal.SchDoc
hardware/Drop_Board/板1PCB_V1/Main_board1.PrjPcb
hardware/Drop_Board/板1PCB_V1/PCB_V2.PcbLib
hardware/Drop_Board/板2PCB_V1/BD2_yd_V1.0.PcbDoc
hardware/Drop_Board/板2PCB_V1/Connect.SchDoc
hardware/Drop_Board/板2PCB_V1/heater_V1.schdoc
hardware/Drop_Board/板2PCB_V1/Main_board2.PrjPcb
hardware/Drop_Board/板2PCB_V1/mySchlib.SchLib
hardware/Drop_Board/板2PCB_V1/PCB_V2.PcbLib
hardware/Drop_Board/板2PCB_V1/加热模块V2.4.PcbLib
hardware/Drop_Board/板3PCB_V1/BD3_yd_V1.0.PcbDoc
hardware/Drop_Board/板3PCB_V1/Connect.SchDoc
hardware/Drop_Board/板3PCB_V1/Main_board3.PrjPcb
hardware/Drop_Board/板3PCB_V1/PCB_V2.PcbLib
hardware/Drop_Board/板3PCB_V1/STM32F407.SchDoc
hardware/Drop_Board/板4PCB_V1/BD4_dy_V1.0.PcbDoc
hardware/Drop_Board/板4PCB_V1/CH634M-R0-1v1.PcbLib
hardware/Drop_Board/板4PCB_V1/Connect.SchDoc
hardware/Drop_Board/板4PCB_V1/Main_board4.PrjPcb
hardware/Drop_Board/板4PCB_V1/mySchlib.SchLib
hardware/Drop_Board/板4PCB_V1/PCB_V2.PcbLib
hardware/Drop_Board/板4PCB_V1/Power.SchDoc
hardware/Drop_Board/板4PCB_V1/USBhub-CH634M-R0-1v1.SchDoc
