zyu43796-byte/Microfluidic-device/(commit log)

2026-10-15 Import validated device firmware and xiuyun desktop host
2026-10-15 Add Drop_Board schematics PCB layouts and hardware documents
